accellarando/TagGang/docs/notes/links.txt

[01] S. M. Sojoudian et al., “Production and supply-chain update,” Raspberry Pi: Production and Supply Chain Update, https://www.raspberrypi.com/news/production-and-supply-chain-update/ (accessed May 10, 2023). 

[02] P. Spencer, “Achievement unlocked: 10 Years – thank you, xbox 360,” Xbox Wire, 20-Apr-2016. [Online]. Available: https://news.xbox.com/en-us/2016/04/20/xbox-360-celebrating-10-years/. [Accessed: 13-Apr-2023]. 

[03] Hickeys, “Kinect for Windows - Windows Apps,” Windows apps | Microsoft Learn. [Online]. Available: https://learn.microsoft.com/en-us/windows/apps/design/devices/kinect-for-windows. [Accessed: 14-Apr-2023]. 

[04] G. Chen, S. Baek, J.-D. Florez, W. Qian, S.-W. Leigh, S. Hutchinson, and F. Dellaert, “GTGraffiti: Spray painting graffiti art from human painting motions with a cable driven parallel robot,” in 2022 IEEE International Conference on Robotics and Automation (ICRA), 2022. [Online]. Available: https://research.gatech.edu/introducing-gtgraffiti-robot-paints-human. [Accessed: 25-Apr-2023].

[05] J. Lehni, U. Franke. "Hektor" juerglehni. [Online]. Available: https://juerglehni.com/works/hektor. [Accessed: 24-Apr-2023].

[06] Davidbliss, “Penelope: A vertical pen plotter,” davidbliss, https://davidbliss.com/2021/09/13/penelope/ (accessed May 10, 2023). 

[07] michi_teck, “MTvplot (vertical plotter),” Thingiverse, https://www.thingiverse.com/thing:2371117 (accessed May 10, 2023). 

[08] Chen, J. Microsoft Xbox 360 Kinect launches November 4. Gizmodo, 14-Jun-2010. from https://gizmodo.com/microsoft-xbox-360-kinect-launches-november-4-5563148 [Accessed: 13-Apr-2023]

[09] “Connect the sensor to the original Console - microsoft xbox 360 Kinect Manual \& Warranty [page 8],” ManualsLib, 23-Mar-2019. [Online]. Available: https://www.manualslib.com/manual/1541058/Microsoft-Xbox-360-Kinect.html?page=8\#manual. [Accessed: 13-Apr-2023]. 

[010] P. Spencer, “Achievement unlocked: 10 Years – thank you, xbox 360,” Xbox Wire, 20-Apr-2016. [Online]. Available: https://news.xbox.com/en-us/2016/04/20/xbox-360-celebrating-10-years/. [Accessed: 13-Apr-2023]. 

[011] Hickeys, “Kinect for Windows - Windows Apps,” Windows apps | Microsoft Learn. [Online]. Available: https://learn.microsoft.com/en-us/windows/apps/design/devices/kinect-for-windows. [Accessed: 14-Apr-2023]. 

[012] OpenKinect, “OpenKinect/libfreenect: Drivers and libraries for the Xbox Kinect device on windows, linux, and OS X,” GitHub. [Online]. Available: https://github.com/OpenKinect/libfreenect. [Accessed: 24-Apr-2023].

- (3992_PrototypeProposal) kinect info

- (3992_PrototypeReflection) further research -> telematic art (telegarden)

There are features in TagGang's Kinect not found in the libfreenect SDK base build that we would like to explore further through the means of other SDK integrations like finger/palm detection.

https://gmv.cast.uark.edu/scanning/hardware/microsoft-kinect-resourceshardware/

https://www.instructables.com/Polargraph-Drawing-Machine/

--- TO DO

CHANGE PEN PLOTTER TO PAINT-PEN PLOTTER

    % FIXME: The Kinect v2 face recognition, motion tracking, and resolution are much more precise than the Kinect v1
    % FIXME: No finger tracking
    % FIXME: DIFFERENT GESTURES -  Draw/move without drawing: hold out hand in front of you while drawing, pull back to stop? As a backup, if that doesn't work - hide your left hand to stop drawing Finish - button on lower right corner of screen? Punch with left hand? or a timer
    % FIXME: NOISE FROM GESTURE
    % FIXME: FAST ENOUGH MOVEMENT

- FSM DIAGRAM
- BLOCK DIAGRAM
- DEMO PIC
- PLOTTER

-----

MILESTONE 3 OCT 27

After Ella provides the blank PCB and electrical components,
Dana will solder the necessary electrical components---following the PCB schematic---that satisfy the specifications
in creating the PCB for the CNC controller. 
At the very most, this process should take 1 week: this accounts for any mistakes made while soldering as well as constant testing to avoid any electrical mishaps.

The completed custom PCB CNC controller attached to the Arduino Uno. 

Ella will create custom 3D-printed parts given by Dana's plotter design specifications which will take 1 week.
 
The design includes the frame's bar and attachments for the stepper motor and toothed cable housing, paint-pen holder, and counterweights.
Then Dana will assemble the plotter's hardware setup and connect it to the rest of the TagGang system in a temporary
environment within 1 week.

Modifications to GRBL for polar plotting should be ready in 1 week within the given time frame and before testing 
of the assembled plotter. 

The temporary environment will allow basic testing of the plotter which is conducted by both members and
subsequently documented, taking 1 week.
