accellarando/TagGang/docs/hardware/plotter.html

# Vertial Paint Pen-Plotter

The plotter for TagGang was comprised of custom-fitted 3D prints, a vertically-elongated rolling whiteboard, 2-phase 1.8 degree/step stepper motors, timing belt and pulley, ball bearings, alongside the various wires and power adapters.
This cable-driven plotter mounts stepper motors to the top corners of the whiteboard. The timing belt is threaded through the mounts, interlocking with the timing pulleys on each stepper motor, and ending with a counterweight that holds pennies. The other end of the belt is attached to an arm of the gondola. The gondola holds the paint pen and servo motor that lifts the gondola off the paper. Long wires connect the motors to the custom Pi Hat hardware to drive them.

## Demo Day Plotter

TagGang's final version of the plotter utilized the CADE lab's vertically-elongated plotter, wrapped with 6' of white butcher paper.
Connecting wires and power adapters not shown in the picture below, but were laid out on the table.

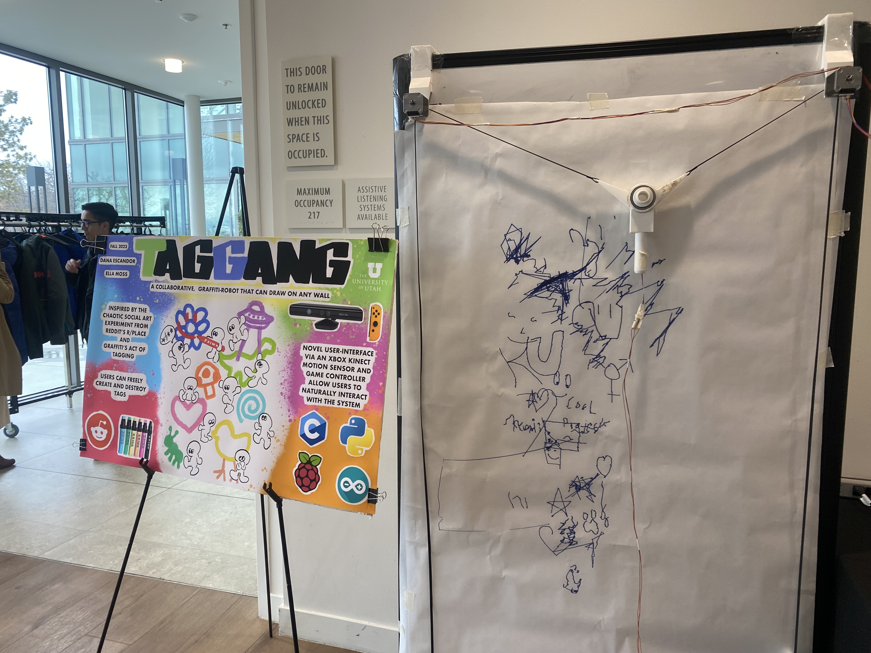
[picture p1: docs/images/taggang-plotter.jpg]
Final Plotter


TagGang's Plotter on Demo Day

Links to plotter items purchased from Amazon, Mouser, and STMicroelectronics:
2x 1 inch ID x 2 inch bearings (https://www.amazon.com/gp/product/B086PVD4XH)
1x 5 meter timing belt and 2x pulleys (https://www.amazon.com/gp/product/B07Y33MF7R?th=1)
1x 9g servo motor (https://www.amazon.com/gp/product/B07Q6JGWNV?th=1)
2x SF2424-10B11 stepper motors (https://www.mouser.com/ProductDetail/SANMOTION/SF2424-10B11?qs=l4Gc20tDgJJPaqhJYMlonw%3D%3D)
2x x-nucleo-ihm05a1 stepper motor driver (https://www.st.com/en/ecosystems/x-nucleo-ihm05a1.html)
1x power adapter (https://www.amazon.com/gp/product/B08C594VNP?th=1)
1x raspberry pi 4 (https://www.raspberrypi.com/products/raspberry-pi-4-model-b/)
Other components bought the from the stockroom or the campus bookstore included: wires, butcher paper, paint pens.

## Plotter Versions

The plotter build went through various iterations and the original build was ultimately scrapped. The original design was geared toward a width-elongated rolling frame as seen in the design:

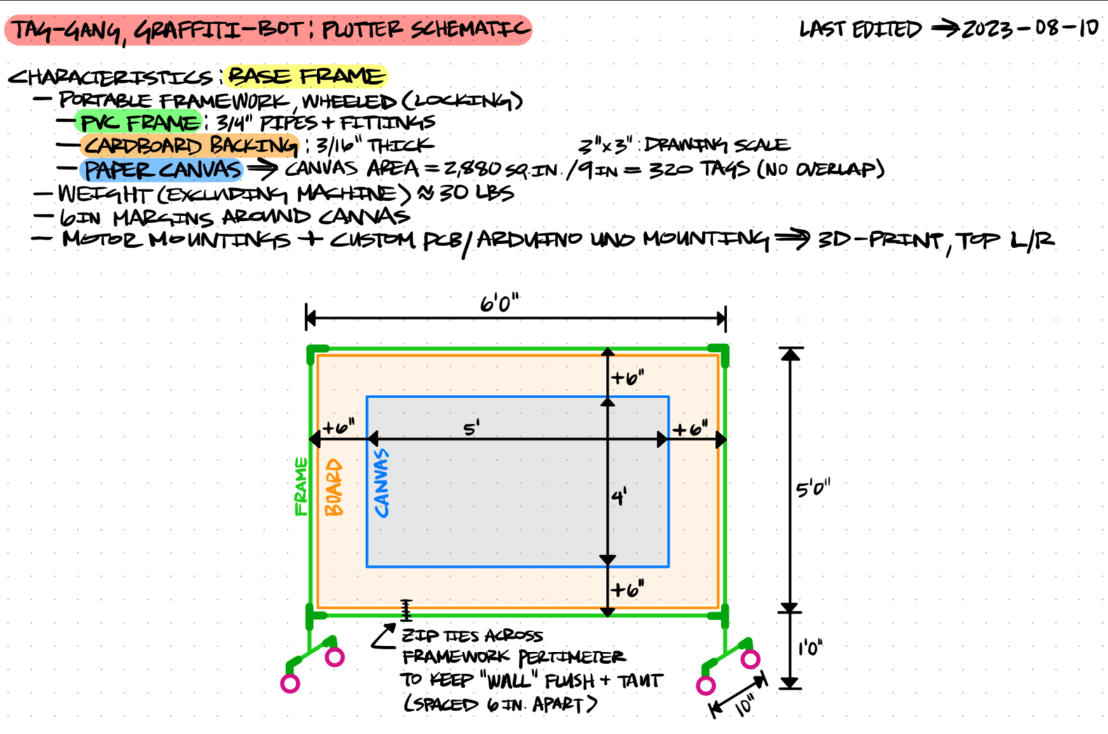
[picture p2: docs/images/PlotterFrame.png]
Final Plotter


V1 plotter schematic

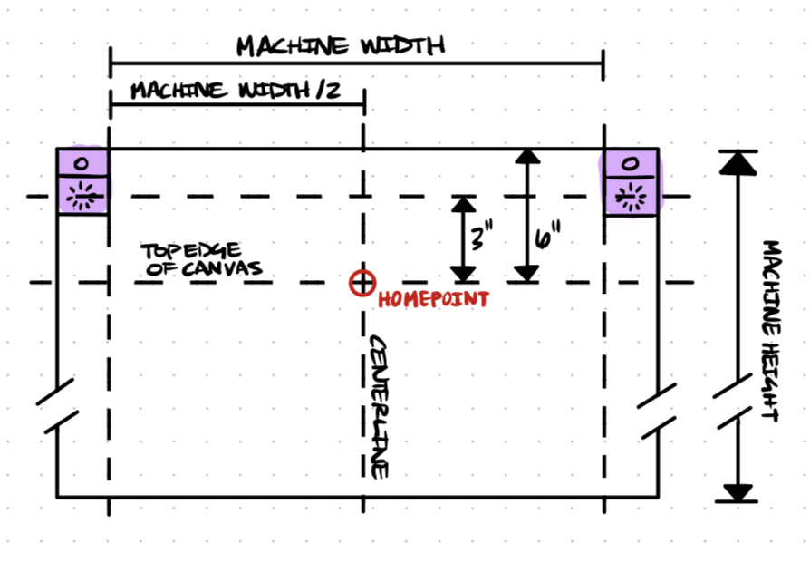
[picture p3: docs/images/PlotterPlacement.png]
Final Plotter


Margins and boundaries for V1 plotter

This first verion was constructed out of PVC pipes and the backing was either cardboard or poster foam board.
The PVC frame was constructed but finding the backing proved to be expensive. Custom sized boards would be an additional cost we didn't want to splurge on. Trying to use recycled cardboard and poster foam boards made an uneven surface:

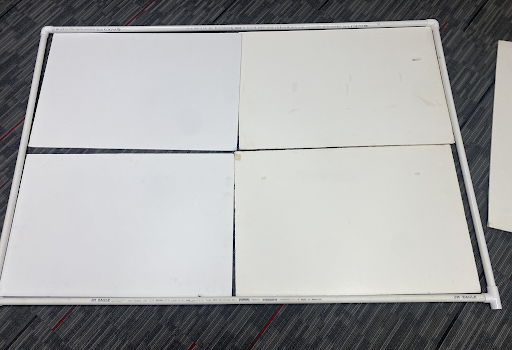
[picture p4: docs/images/plotterv1.png]
Final Plotter


V1 plotter laid out

We then received a thin whiteboard from our professor but was too flimsy and could not hold the weight of the stepper motors:

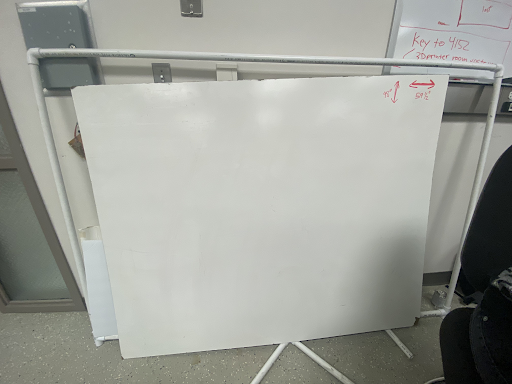
[picture p5: docs/images/whiteboard.png]


Given whiteboard for V2

## 3D-Prints

There were multiple versions of the 3D-prints due to the verious versions of the plotter. The working and final 3D prints can be found in our repo within selector-commands branch in plotter-frame (https://github.com/accellarando/TagGang/tree/selector-commands/plotter-frame).
Here's a preview of one print, the gondola:

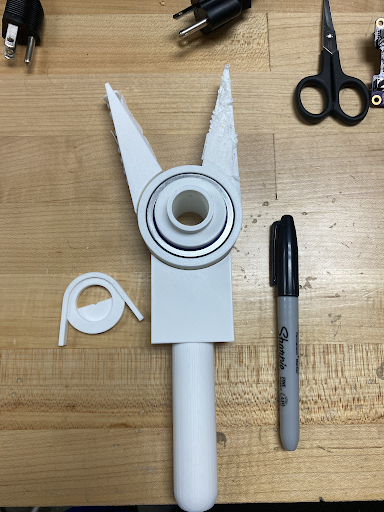
[picture p6: docs/images/gondola-front.png]


gondola front

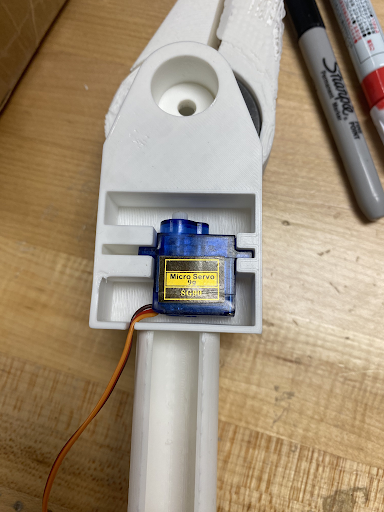
[picture p7: docs/images/gondola-back.png]


gondola back
