accellarando/TagGang/docs/hardware/hat.html

# CNC Pi HAT

As part of our project, we have designed a custom PCB to interface with the Raspberry Pi. Raspberry Pi has published a specification (https://github.com/raspberrypi/hats/) for breakout boards, called the Pi HAT (Hardware Attached on Top). These boards communicate with the Pi over GPIO pins, which can also be programmed to perform functions such as serial output.
The TagGang project requires fine stepper motor and servo control. The Raspberry Pi, which runs a desktop operating system, is not equipped for this timing-sensitive application. To meet this need, the team has decided to design a Pi HAT with a microcontroller to extend the capabilities of the Raspberry Pi. This PCB contains a microcontroller, stepper motor drivers, and an Arduino.
The team decided on an Arduino due to existing support for CNC applications, with libraries such as GRBL (https://github.com/gnea/grbl).

## Schematic

Ella designed the schematic for the Pi HAT, which contains a microcontroller, two DRV8825 stepper motor drivers, and other hardware to link everything together (such as level shifters - the Pi runs at 3.3V, while the Arduino runs at 5V).

## PCB

After the schematic was finished, the PCB was designed to the Pi HAT specification, linked above.

## Files

Browse the GitHub (https://github.com/accellarando/TagGang/tree/main/hardware) for the schematic, board layout, and bill of materials.
