accellarando/TagGang/hardware/CAMOutputs/ImageFiles/ v27.pdf

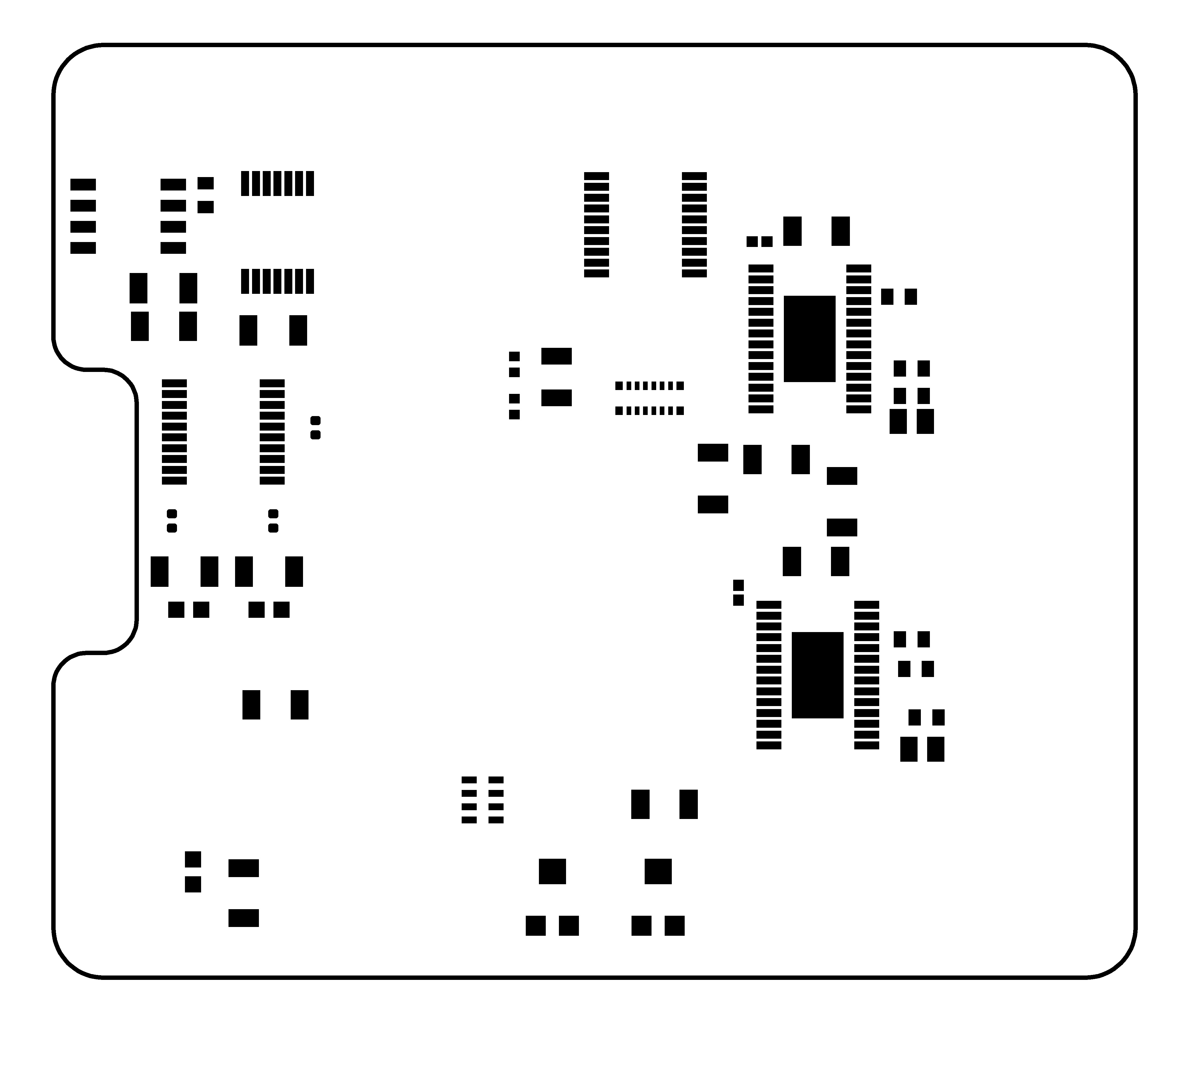
[picture p8: figure]

Image 1
