accellarando/TagGang/hardware/CAMOutputs/ImageFiles/5780/TagGang/CAMOutputs/ImageFiles/Image 1.pdf

Image 1
