accellarando/TagGang/docs/images/3DprintStepperMount.png

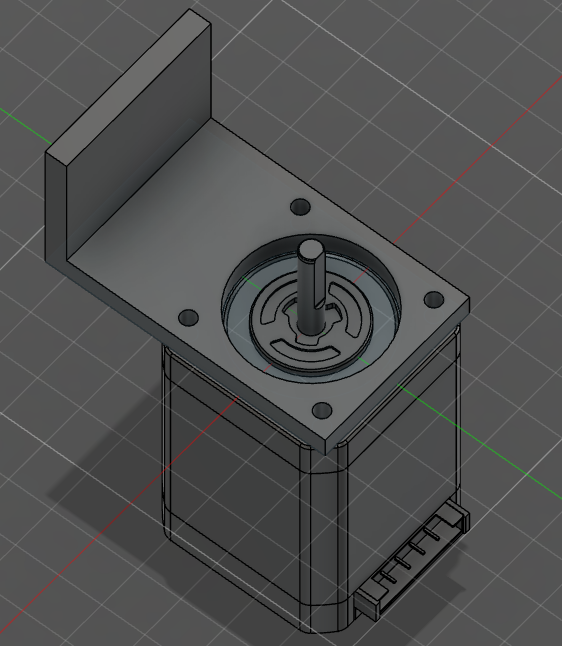
docs/images/3DprintStepperMount.png
