accellarando/TagGang/docs/images/dana.jpg

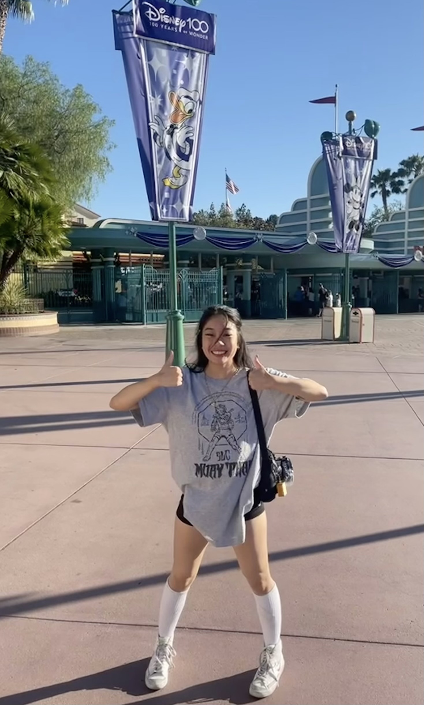
docs/images/dana.jpg
