accellarando/TagGang/docs/images/ella.jpg

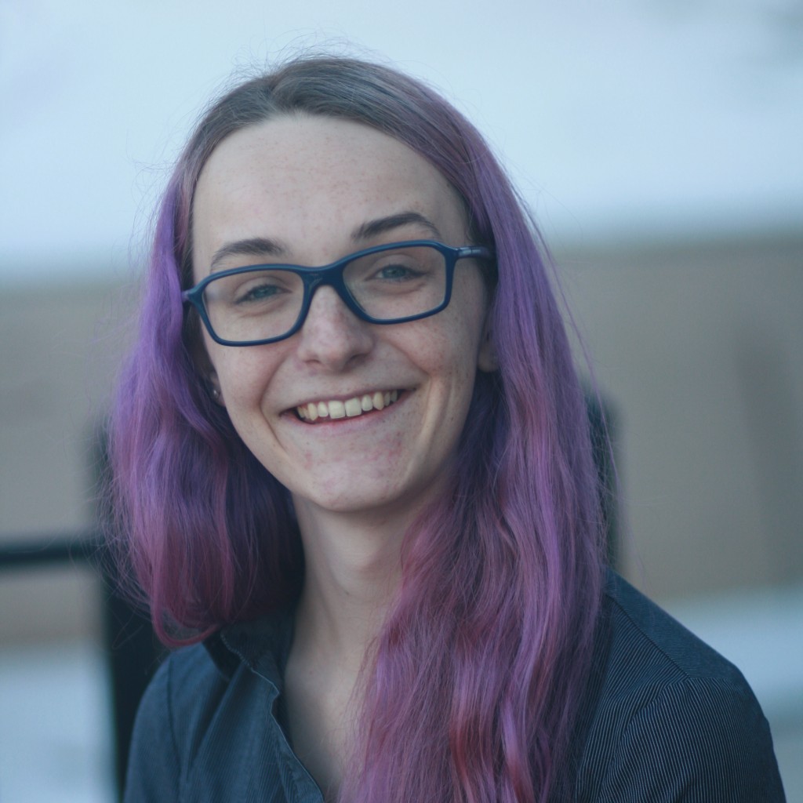
docs/images/ella.jpg
