accellarando/TagGang/docs/images/GTGraffiti.PNG

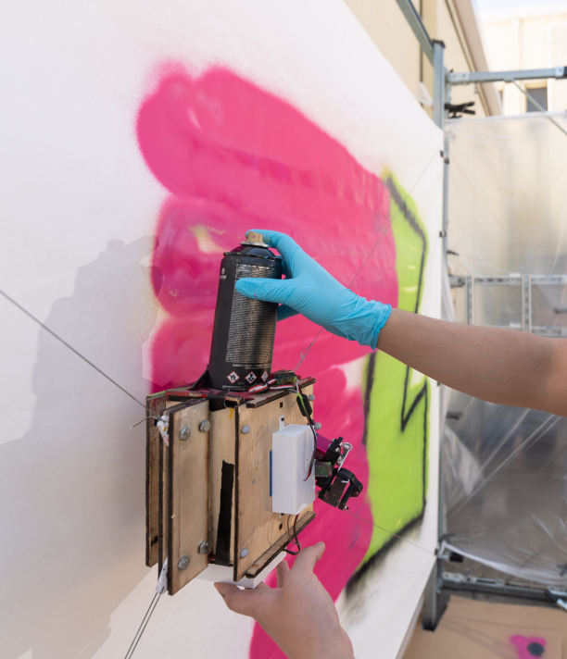
docs/images/GTGraffiti.PNG
