accellarando/TagGang/docs/images/HektorTitlesAShow.PNG

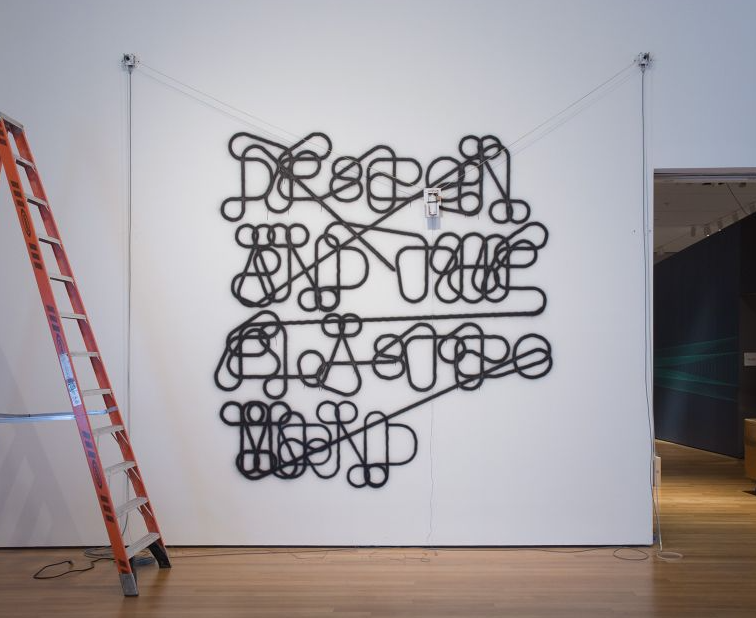
docs/images/HektorTitlesAShow.PNG
