accellarando/TagGang/docs/images/pcb.png

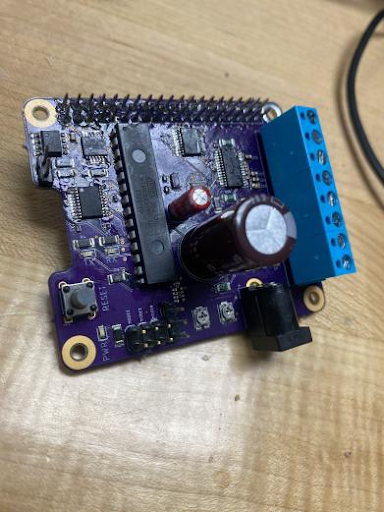
docs/images/pcb.png
