accellarando/TagGang/docs/images/Penelope.PNG

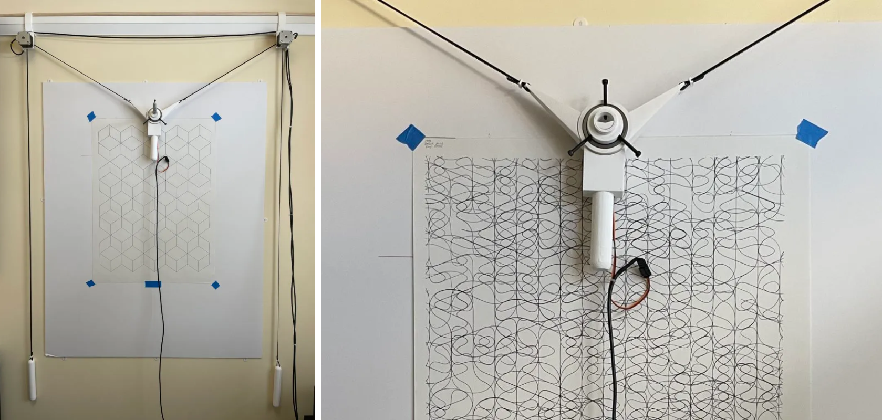
docs/images/Penelope.PNG
