accellarando/TagGang/docs/images/PiHat.jpg

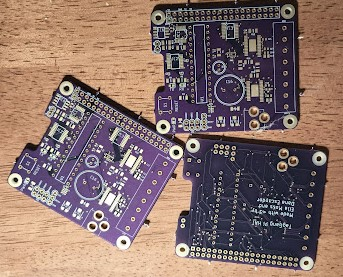
docs/images/PiHat.jpg
