accellarando/TagGang/docs/images/PlotterUnfin.jpg

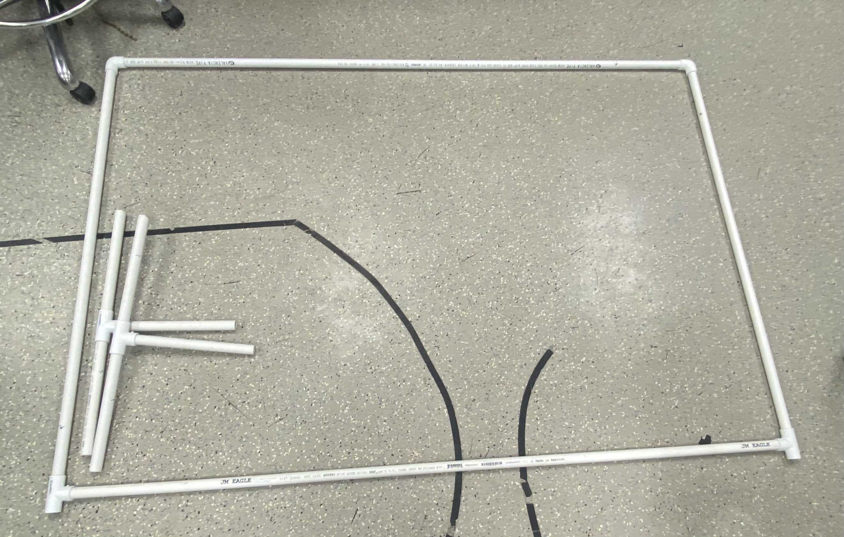
docs/images/PlotterUnfin.jpg
