accellarando/TagGang/docs/images/PrototypeBlockDiagram.png

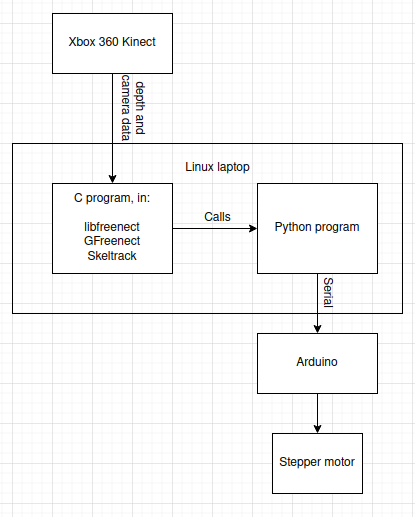
docs/images/PrototypeBlockDiagram.png
