accellarando/TagGang/docs/images/TagGangBlockDiagram.png

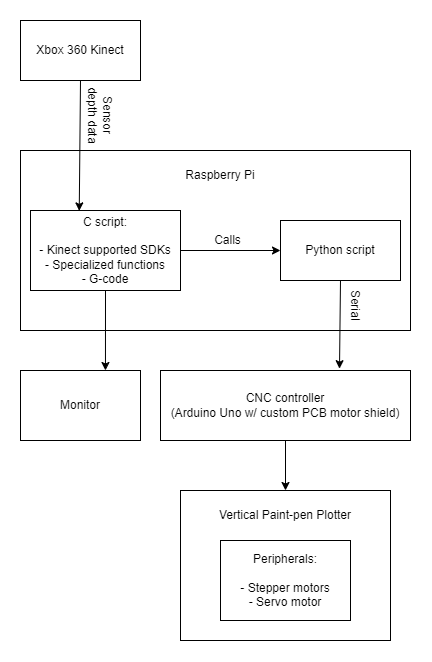
docs/images/TagGangBlockDiagram.png
