accellarando/TagGang/docs/images/TagGangDemo.png

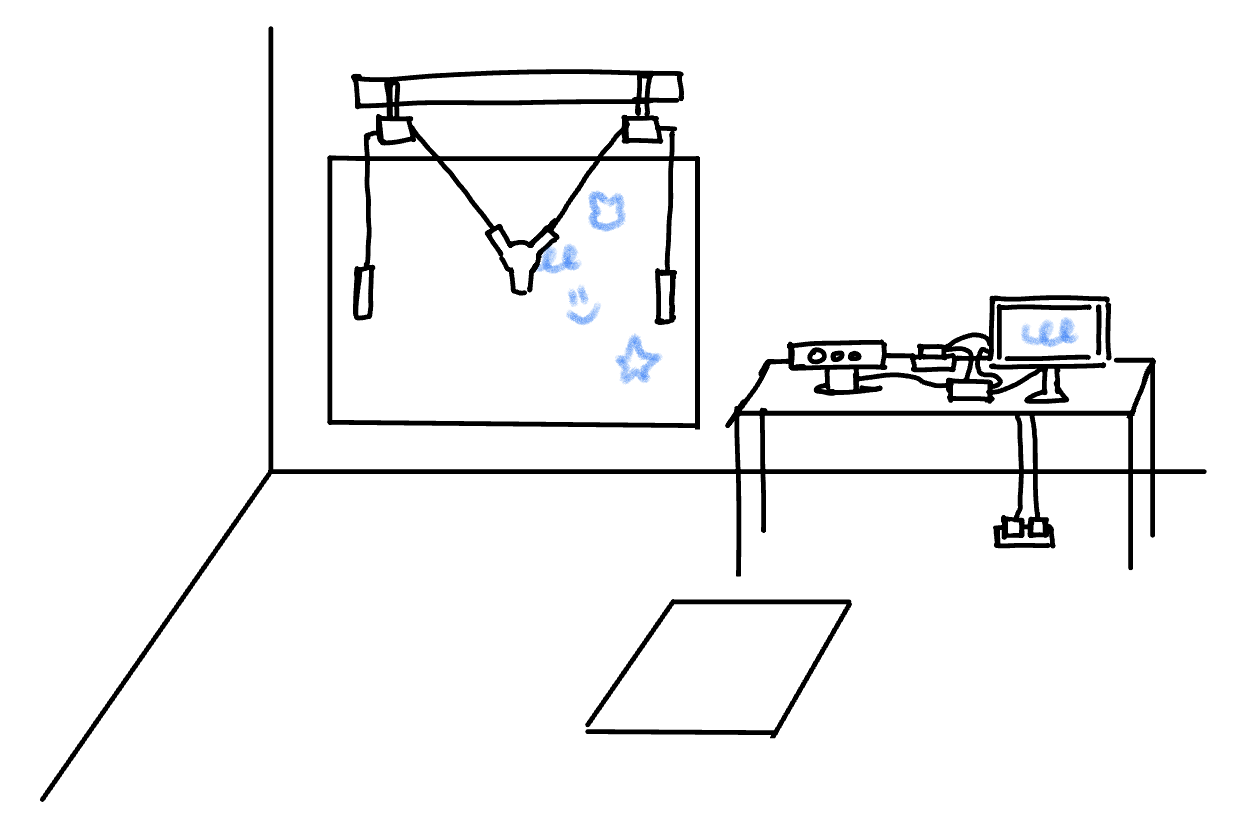
docs/images/TagGangDemo.png
