accellarando/TagGang/hardware/blockDiagram.png

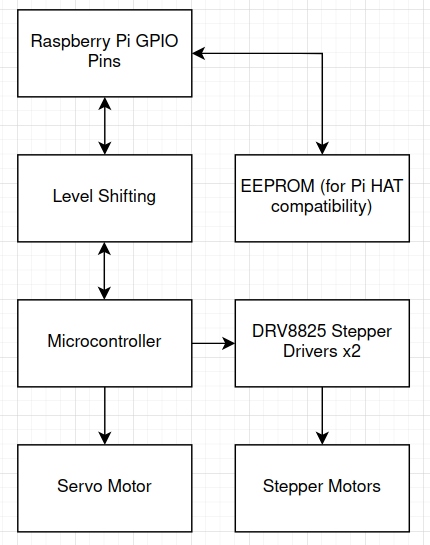
hardware/blockDiagram.png
