accellarando/TagGang/hardware/Schematic-v1.3.png

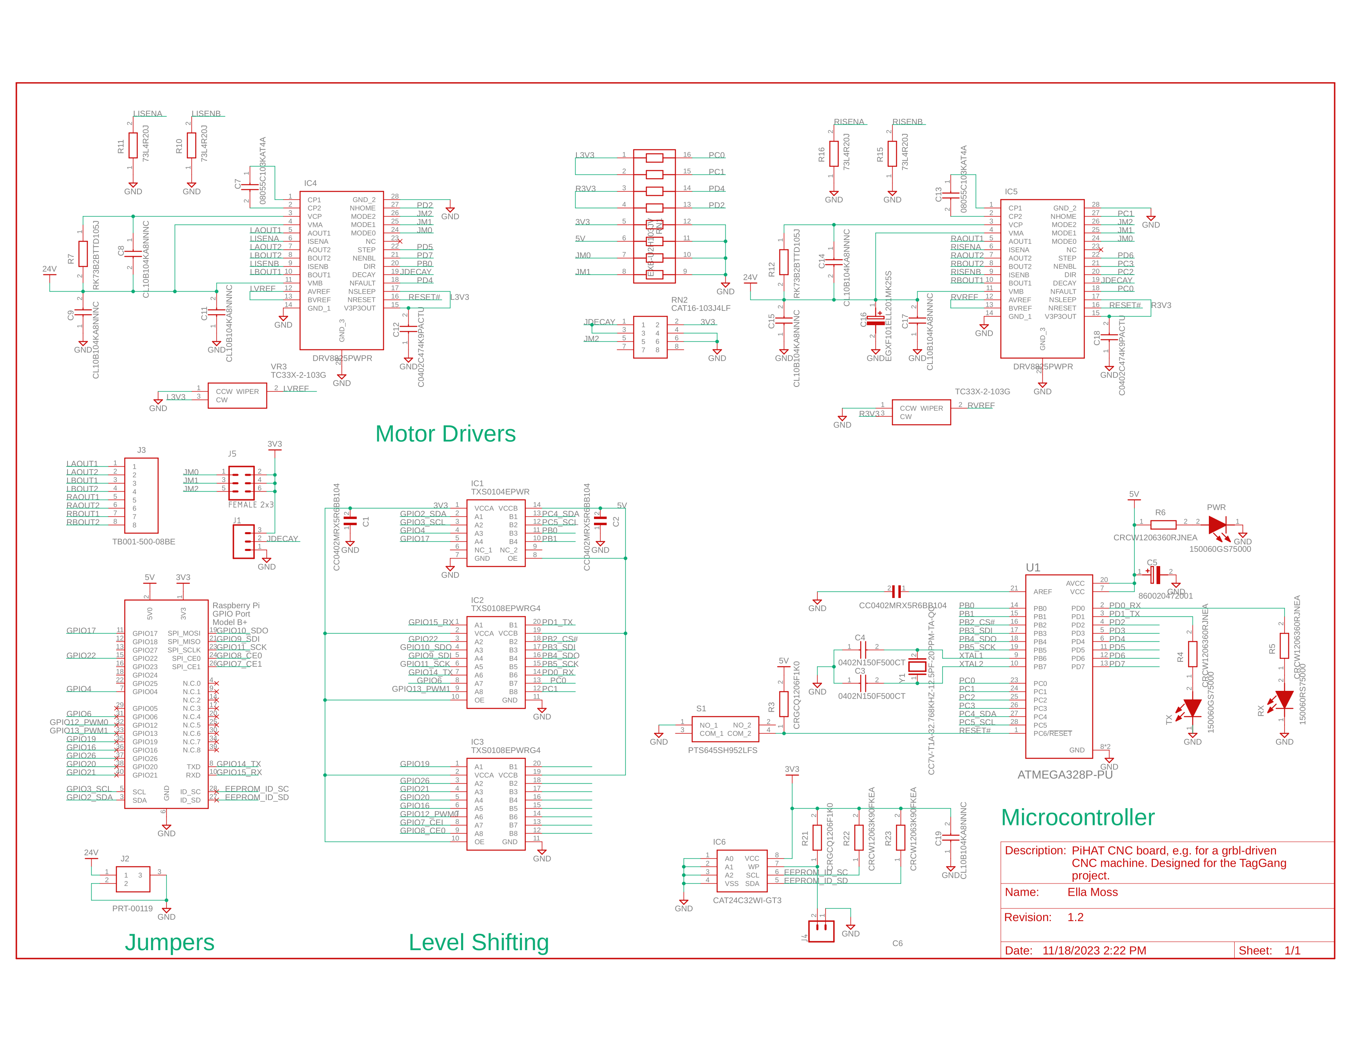
hardware/Schematic-v1.3.png
