accellarando/TagGang/software/images/flower.png

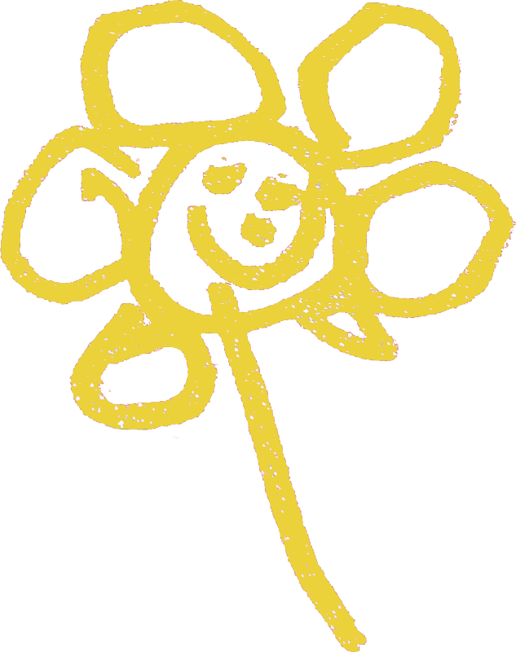
software/images/flower.png
