accellarando/TagGang/software/images/stick-figure.png

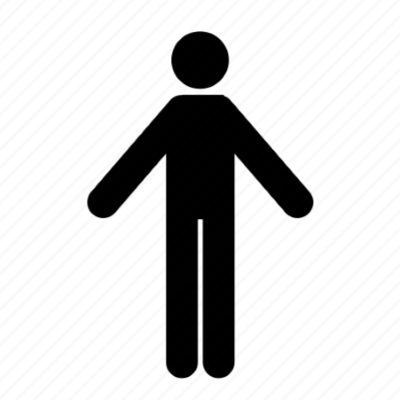
software/images/stick-figure.png
