accellarando/TagGang/hardware/BOM-v1.2.ods

Qty | Value | Parts | Device | DESCRIPTION | Price | Total Cost | MOUSER LINK
1 | CONN_02 | J4 | CONN_02 |  |  | 0
1 | CONN_03 | J1 | CONN_03 |  |  | 0
2 | 0402N150F500CT | C3, C4 | 0402N150F500CT | Multilayer Ceramic Capacitors MLCC - SMD/SMT 0402 MLCC NPO 15 pF +/- 1% 50 V T&R GP | $0.10 | $0.20 | https://www.mouser.com/ProductDetail/Walsin/0402N150F500CT?qs=ZrPdAQfJ6DMIGRPPEte55Q%3D%3D
2 | 08055C103KAT4A | C7, C13 | 08055C103KAT4A | Multilayer Ceramic Capacitors MLCC - SMD/SMT 50V .01uF X7R 0805 10%TOL | $0.10 | $0.20 | https://www.mouser.com/ProductDetail/KYOCERA-AVX/08055C103KAT4A?qs=rjW0lv%2FNY4MU4YjuQDXlLw%3D%3D
2 | 150060GS75000 | PWR, TX | 150060GS75000 | Wurth Elektronik WL-SMCW 520 nm Green LED, 1608 (0603) Clear SMD package | 0.15 | 0.3 | https://www.mouser.com/ProductDetail/Wurth-Elektronik/150060GS75000?qs=LlUlMxKIyB0UYkq5lDO8nA%3D%3D
1 | 150060RS75000 | RX | 150060RS75000 | WURTH ELEKTRONIK - 150060RS75000 - LED, 0603, RED, 250MCD, 625NM | $0.15 | $0.15 | https://www.mouser.com/ProductDetail/Wurth-Elektronik/150060RS75000?qs=LlUlMxKIyB3QnmZ3fw%2FVCA%3D%3D
4 | 73L4R20J | R10, R11, R15, R16 | 73L4R20J | Current Sense Resistors - SMD 0.2ohms 5% | $0.21 | $0.84 | https://www.mouser.com/ProductDetail/CTS-Electronic-Components/73L4R20J?qs=hbgUSdfWRJU6l%2FyD8DKbaA%3D%3D
1 | 860020472001 | C5 | 860020472001 | Wurth Elektronik 4.7uF 25 V dc Aluminium Electrolytic Capacitor, WCAP-ATG5 Series 2000h 5 (Dia.) x 11mm | $0.10 | $0.10 | https://www.mouser.com/ProductDetail/Wurth-Elektronik/860020472001?qs=0KOYDY2FL2%2F%252BlYkeK95R6A%3D%3D
1 | ATMEGA328P-PU | U1 | ATMEGA328P-PU | microcontroller | $2.97 | $2.97 | https://www.mouser.com/ProductDetail/Microchip-Technology/ATMEGA328P-PU?qs=K8BHR703ZXguOQv3sKbWcg%3D%3D
2 | C0402C474K9PACTU | C12, C18 | C0402C474K9PACTU | SMD Comm X5R, Ceramic, 0.47 uF, 10%, 6.3 VDC, 15.75 VDC, 85C, -55C, X5R, SMD, MLCC, Temperature Stable, Class II, 10 % , 1.0638 GOhms, 1.21 mg, 0402, 1mm, 0.5mm, 0.5mm, 0.3mm, 0.3mm, 10000, 78 Weeks, 70 | $0.10 | $0.20 | https://www.mouser.com/ProductDetail/KEMET/C0402C474K9PACTU?qs=KHg1sw%2FVM5RivoKJ3oVJkQ%3D%3D
1 | CAT24C32WI-GT3 | IC6 | CAT24C32WI-GT3 | EEPROM Serial-I2C 32K 4Kx8 1.8V/5V SOIC8 CAT24C32WI-GT3, EEPROM Memory 32kbit,, 4096 x, 8bit, Serial-I2C 1.7 5.5 V, 8-Pin SOIC | $0.37 | $0.37 | https://www.mouser.com/ProductDetail/onsemi/CAT24C32WI-GT3?qs=rZgeL6XvLwaTa79VuYkKQA%3D%3D
3 | CC0402MRX5R6BB104 | C1, C2, C6 | CC0402MRX5R6BB104 | 0.1 µF ±20% 10V Ceramic Capacitor X5R 0402 (1005 Metric) | 0.12 for 10 | $0.12 | https://www.mouser.com/ProductDetail/YAGEO/CC0402MRX5R6BB104?qs=57cj7OiSijkr3nExJ5eVHg%3D%3D
1 | CC7V-T1A-32.768KHZ-12.5PF-20PPM-TA-QC | Y1 | CC7V-T1A-32.768KHZ-12.5PF-20PPM-TA-QC | LOW FREQUENCY CRYSTAL | $0.71 | $0.71 | https://www.mouser.com/ProductDetail/Micro-Crystal/CC7V-T1A-32.768kHz-12.5pF-20PPM-TA-QC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
7 | CL10B104KA8NNNC | C8, C9, C11, C14, C15, C17, C19 | CL10B104KA8NNNC | Ceramic cap 0603 X7R 25V 100nF (Reel) Samsung Electro-Mechanics 100nF Multilayer Ceramic Capacitor (MLCC) 25 V +/-10% X7R dielectric CL max op. temp. +125C | $0.14 for 10 | $0.14 | https://www.mouser.com/ProductDetail/Samsung-Electro-Mechanics/CL10B104KA8NNNC?qs=349EhDEZ59rmu3pGeZXx0A%3D%3D
3 | CRCW1206360RJNEA | R4, R5, R6 | CRCW1206360RJNEA | Thick Film Resistors - SMD 1/4watt 360ohms 5% | 0.1 | 0.3 | https://www.mouser.com/ProductDetail/Vishay-Dale/CRCW1206360RJNEA?qs=f6iYHOF0qgQa5fU%252BdQhP8Q%3D%3D
2 | CRCW12063K90FKEA | R22, R23 | CRCW12063K90FKEA | CRCW1206 Resistor T/R 0.25W,1%,3K9 Vishay CRCW Series Thick Film Surface Mount Resistor 1206 Case 3.9k +/-1% 0.25W +/-100ppm/C | 0.1 | 0.2 | https://www.mouser.com/ProductDetail/Vishay-Dale/CRCW12063K90FKEA?qs=cIcnZvs8mCNkQ0vWXL23Cw%3D%3D
2 | CRGCQ1206F1K0 | R3, R21 | CRGCQ1206F1K0 | SMD AEC-Q200 Compliant Thick Film Chip Resistor, | 0.1 | 0.2 | https://www.mouser.com/ProductDetail/TE-Connectivity-Holsworthy/CRGCQ1206F1K0?qs=wUXugUrL1qxm2LgdVtGvlQ%3D%3D
2 | DRV8825PWPR | IC4, IC5 | DRV8825PWPR | 2.5A Bipolar Stepper Motor Driver with On-Chip 1/32 Microstepping Indexer (Step/Dir Ctrl) | 5.57 | 11.14 | https://www.mouser.com/ProductDetail/Texas-Instruments/DRV8825PWPR?qs=L4ss%2FyqpMWRQV%252B0JWK8r%2FQ%3D%3D
1 | EGXF101ELL201MK25S | C16 | EGXF101ELL201MK25S | Aluminum Electrolytic Capacitors - Radial Leaded 200uF 100 Volts 20% | 2.41 | 2.41 | https://www.mouser.com/ProductDetail/Chemi-Con/EGXF101ELL201MK25S?qs=8BXZADTIn4FXlUL9JzZ4Ow%3D%3D
1 | EXB-U2H103JV | RN1 | EXB-U2H103JV | Series/Type: Anti-Sulfurated Chip Resistor Array, Power Rating (W): 0.063, Chip Size (LxW) (mm): 3.8 X 1.6, Resistance Values (): 10000, Resistance Tolerance (%): 5, Terminal Pitch (mm): 0.5, Type of Circuit: Isolated Circuit, Number of Elements (piece): 8, T.C.R (10/K): +/-200, Number of Terminals (piece): 16 | 0.41 | 0.41 | https://www.mouser.com/ProductDetail/Panasonic/EXB-U2H103JV?qs=Z3CaLxJiOJJ7jC1v10U%2Fjw%3D%3D
1 | CAT16-103J4LF | RN2 | CAT16-103J4LF | 4x 10k Resistor Network | 0.1 | 0.1 | https://www.mouser.com/ProductDetail/Bourns/CAT16-103J4LF?qs=yksRZAkH7gsi20GVw368rQ%3D%3D
1 | FEMALE 2x3 | J5 | CONN_03X2FEMALE |  |  | 0
1 | PRT-00119 | J2 | PRT-00119 | SparkFun Accessories DC Barrel Power Jack/Connector | 1.25 | 1.25 | https://www.mouser.com/ProductDetail/SparkFun/PRT-00119?qs=WyAARYrbSnbnQpS9xf%252Bx5A%3D%3D
1 | PTS645SH952LFS | S1 | PTS645SH952LFS | SWITCH TACTILE SPST-NO 0.05A 12V | 0.23 | 0.23 | https://www.mouser.com/ProductDetail/CK/PTS645SH952LFS?qs=FQH5YrIbzh%252B2bZJSGdqIFg%3D%3D
1 | RASPI_BOARD_B+_HD | X1 | RASPI_BOARD_B+_HD |  | 1.94 | 1.94 | https://www.mouser.com/ProductDetail/SparkFun/PRT-16763?qs=W%2FMpXkg%252BdQ5xeCq%2FGKjnlQ%3D%3D
2 | RK73B2BTTD105J | R7, R12 | RK73B2BTTD105J | Thick Film Resistors - SMD 1/4watts 1Mohms 5% | 0.1 | 0.2 | https://www.mouser.com/ProductDetail/KOA-Speer/RK73B2BTTD105J?qs=R%2FhS%252B3qKYyBMnZWhPzrWSA%3D%3D
1 | TB001-500-08BE | J3 | TB001-500-08BE | Fixed Terminal Blocks Terminal block, screw type, 5.00 , horizontal, 8 poles, CUI Blue, slotted screw, PCB mount | 1.29 | 1.29 | https://www.mouser.com/ProductDetail/CUI-Devices/TB001-500-04BE
2 | TC33X-2-103G | VR3, VR4 | TC33X-2-103G | Trimmer Resistors - SMD 3MM 10KOHMS 25% 0.1WATT OPEN FRM | 0.28 | 0.56 | https://www.mouser.com/ProductDetail/Bourns/TC33X-2-103G
1 | TXS0104EPWR | IC1 | TXS0104EPWR | TXS0104EPWR, Voltage Level Translator, Open Drain 1.65 3.6 V, 2.3 5.5 V 14-Pin TSSOP | 1.15 | 1.15 | https://www.mouser.com/ProductDetail/Texas-Instruments/TXS0104EPWR?qs=7kv20MEVUlglsv2MH6ZndA%3D%3D
2 | TXS0108EPWRG4 | IC2, IC3 | TXS0108EPWRG4 | Translation - Voltage Levels 8B Bidir Vltg-Level Translator | 1.53 | 3.06 | https://www.mouser.com/ProductDetail/595-TXS0108EPWRG4
 |  |  |  |  | SUM: | 30.74
