accellarando/TagGang/hardware/5780/TagGang/CAMOutputs/DrawingFiles/ v27.dxf

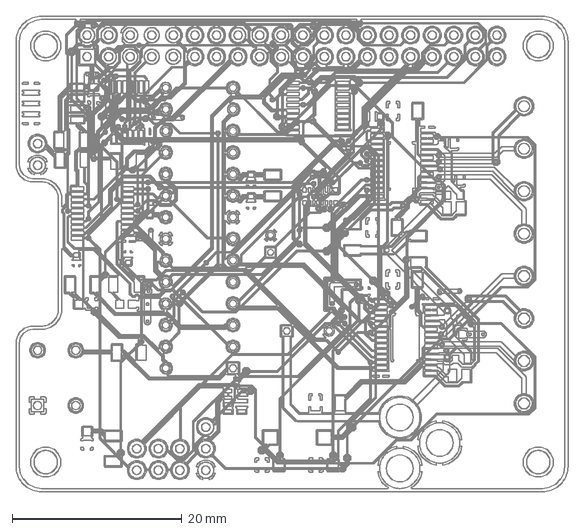
[picture p25: CAD file, 2023-11-14]
hardware/5780/TagGang/CAMOutputs/DrawingFiles/ v27.dxf
65.0 x 56.0 mm
