accellarando/TagGang/hardware/CAMOutputs/DrawingFiles/PiHatOshpark.dxf

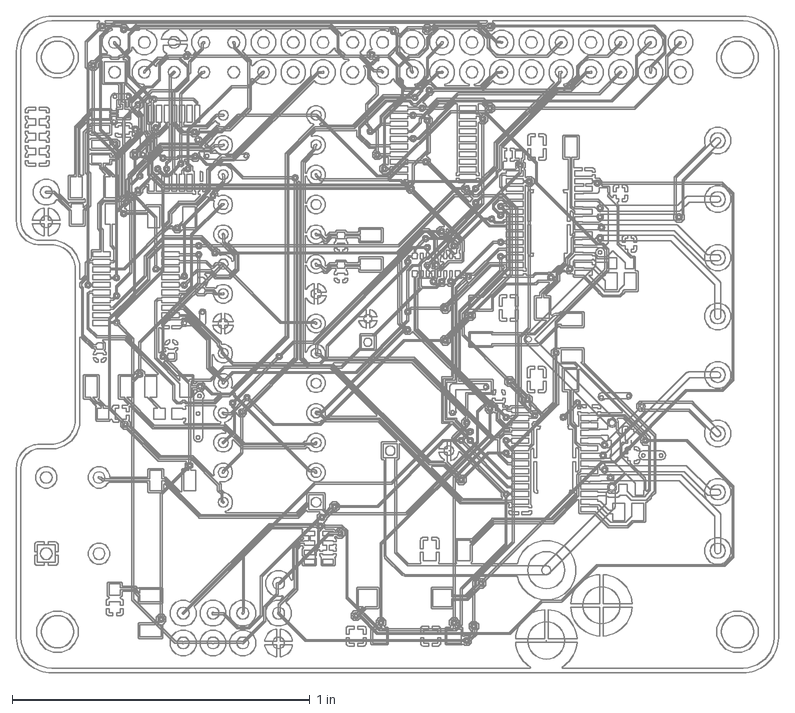
[picture p26: CAD file, 2023-11-14]
hardware/CAMOutputs/DrawingFiles/PiHatOshpark.dxf
2.56 x 2.20 in
