accellarando/TagGang/plotter-frame/gondola-2.stl

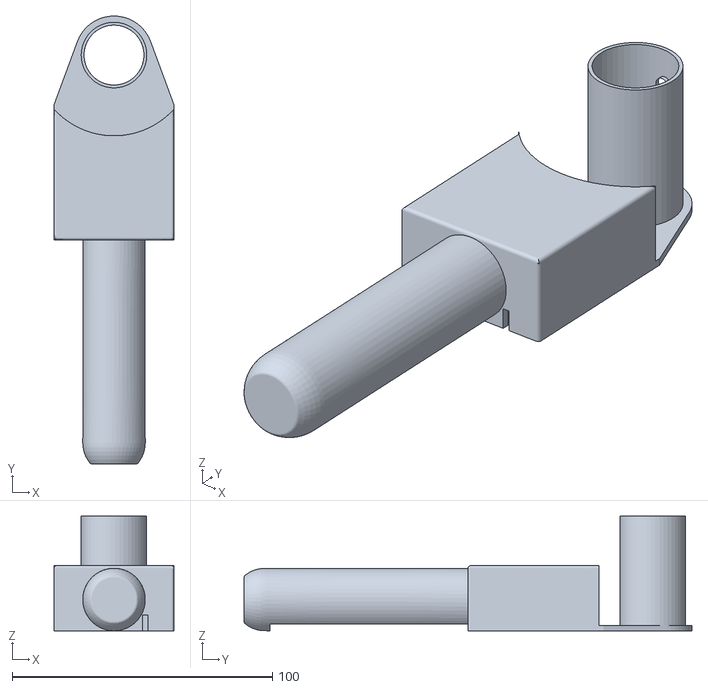
[picture p27: CAD file, 2023-12-21]
plotter-frame/gondola-2.stl
46.0 x 172.0 x 44.0
