accellarando/TagGang/plotter-frame/stl/servo-extender.stl

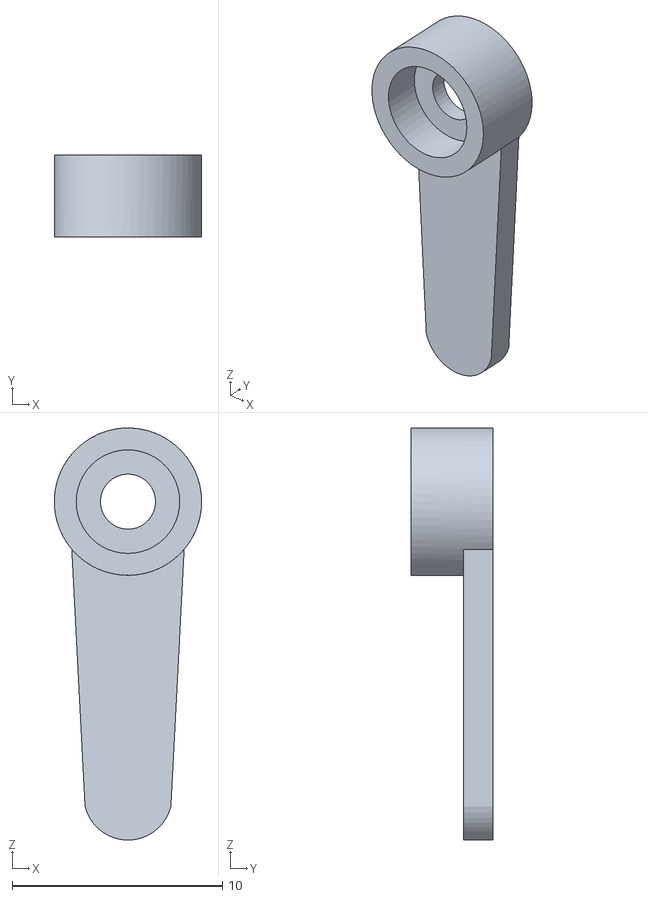
[picture p28: CAD file, 2023-11-25]
plotter-frame/stl/servo-extender.stl
7.00 x 3.91 x 19.6
