accellarando/TagGang/plotter-frame/stl/pulley-holder.stl

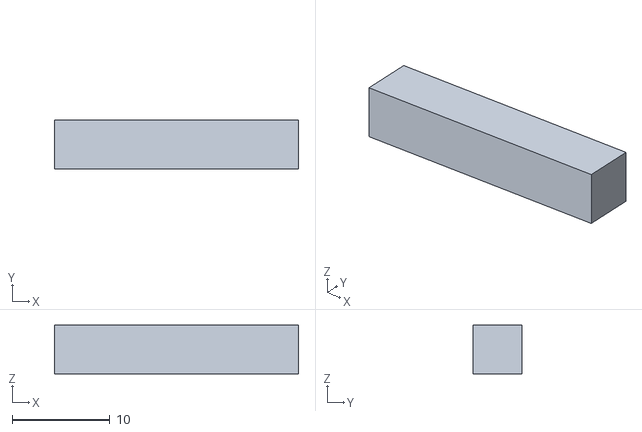
[picture p29: CAD file, 2023-11-25]
plotter-frame/stl/pulley-holder.stl
25.0 x 5.00 x 5.00
