accellarando/TagGang/plotter-frame/stepper-motor-mount-fin-1.stl

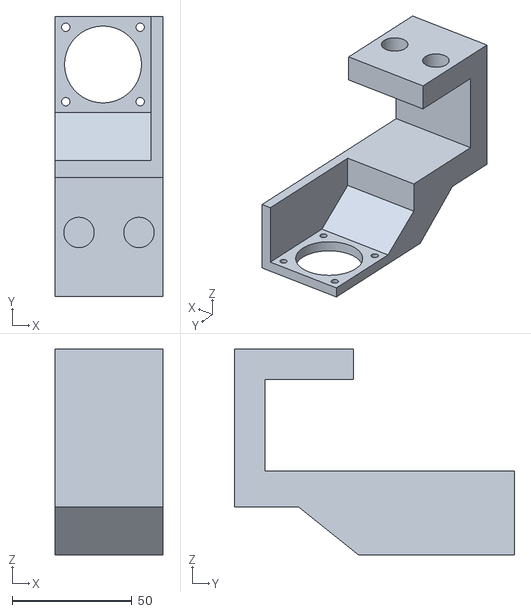
[picture p30: CAD file, 2023-12-21]
plotter-frame/stepper-motor-mount-fin-1.stl
45.0 x 116.7 x 85.8
