accellarando/TagGang/plotter-frame/stl/StepperMotorMount_2_v2.stl

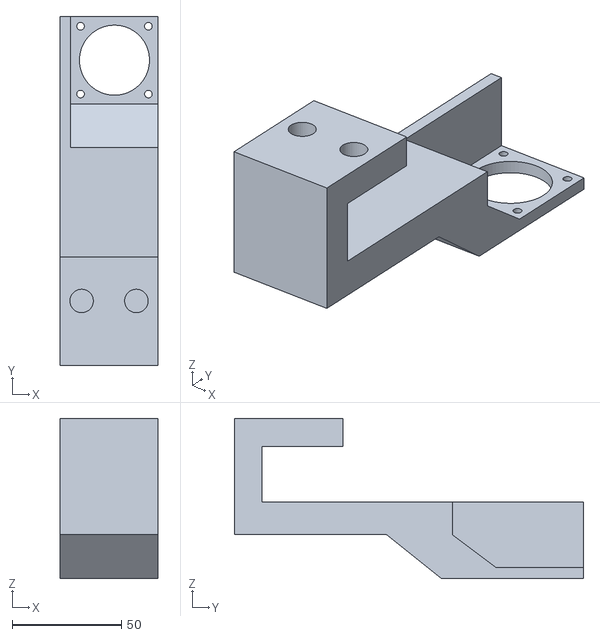
[picture p31: CAD file, 2023-11-20]
plotter-frame/stl/StepperMotorMount_2_v2.stl
45.0 x 159.5 x 73.1
