accellarando/TagGang/plotter-frame/Stepper+Motor+Mount+2.stl

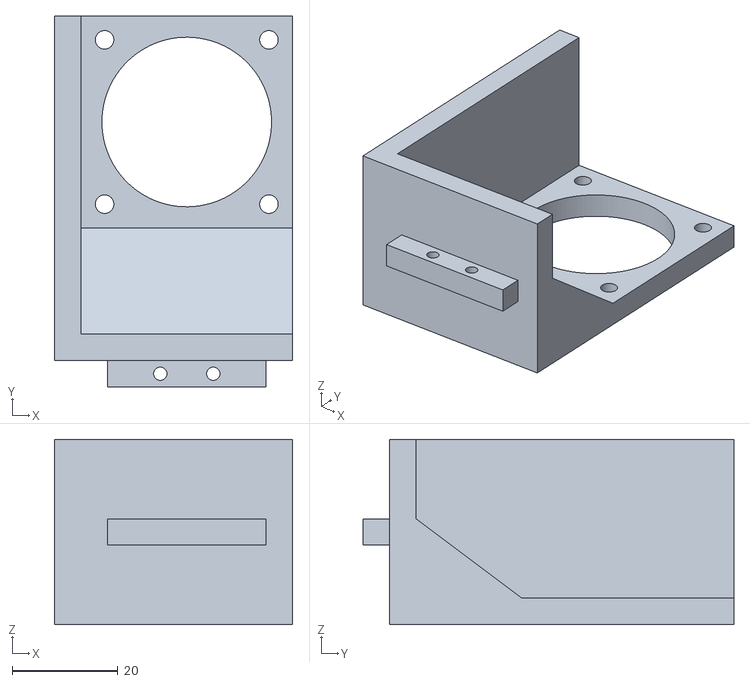
[picture p32: CAD file, 2023-10-31]
plotter-frame/Stepper+Motor+Mount+2.stl
45.0 x 70.0 x 35.0
