accellarando/TagGang/plotter-frame/SANMOTION-F2-SF2424-10B11.STEP

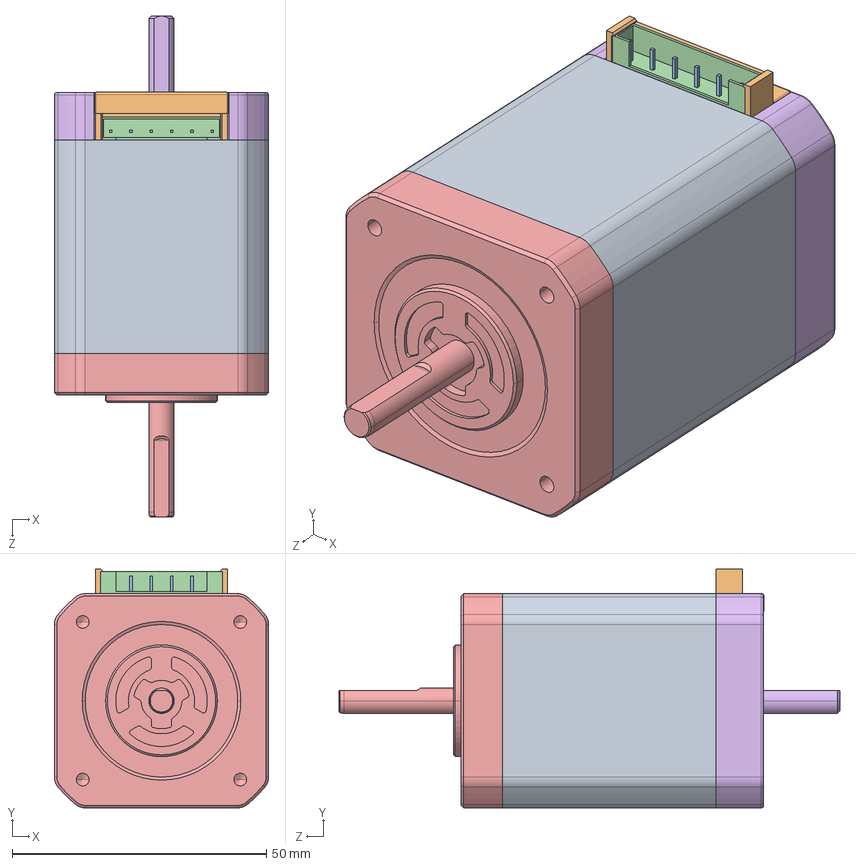
[picture p33: CAD file, 2023-09-04]
plotter-frame/SANMOTION-F2-SF2424-10B11.STEP
42.2 x 47.0 x 98.6 mm
