accellarando/TagGang/plotter-frame/Stepper Motor Mount v1.stl

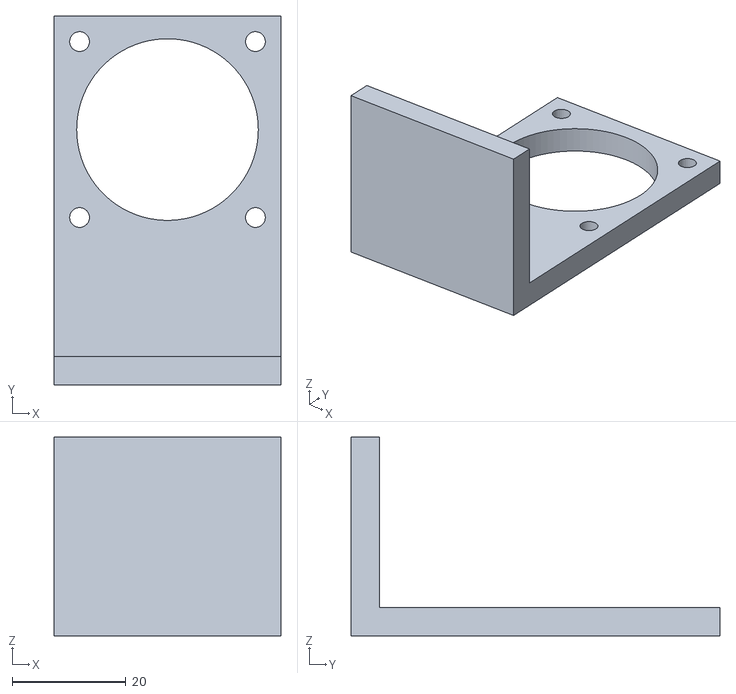
[picture p34: CAD file, 2023-09-04]
plotter-frame/Stepper Motor Mount v1.stl
40.0 x 65.0 x 35.0
