accellarando/TagGang/(list of files, cad)

Other CAD files:
plotter-frame/gondola-3.stl
plotter-frame/stepper-motor-mount-fin-2.stl
plotter-frame/stl/StepperMotorMount_1_v2.stl
plotter-frame/Stepper+Motor+Mount+1.stl
hardware/PiHAT-v1.2.f3z
hardware/PiHat-v1.1.f3z
