accellarando/TagGang/hardware/Schematic-v1.3.pdf

# 16 RN2

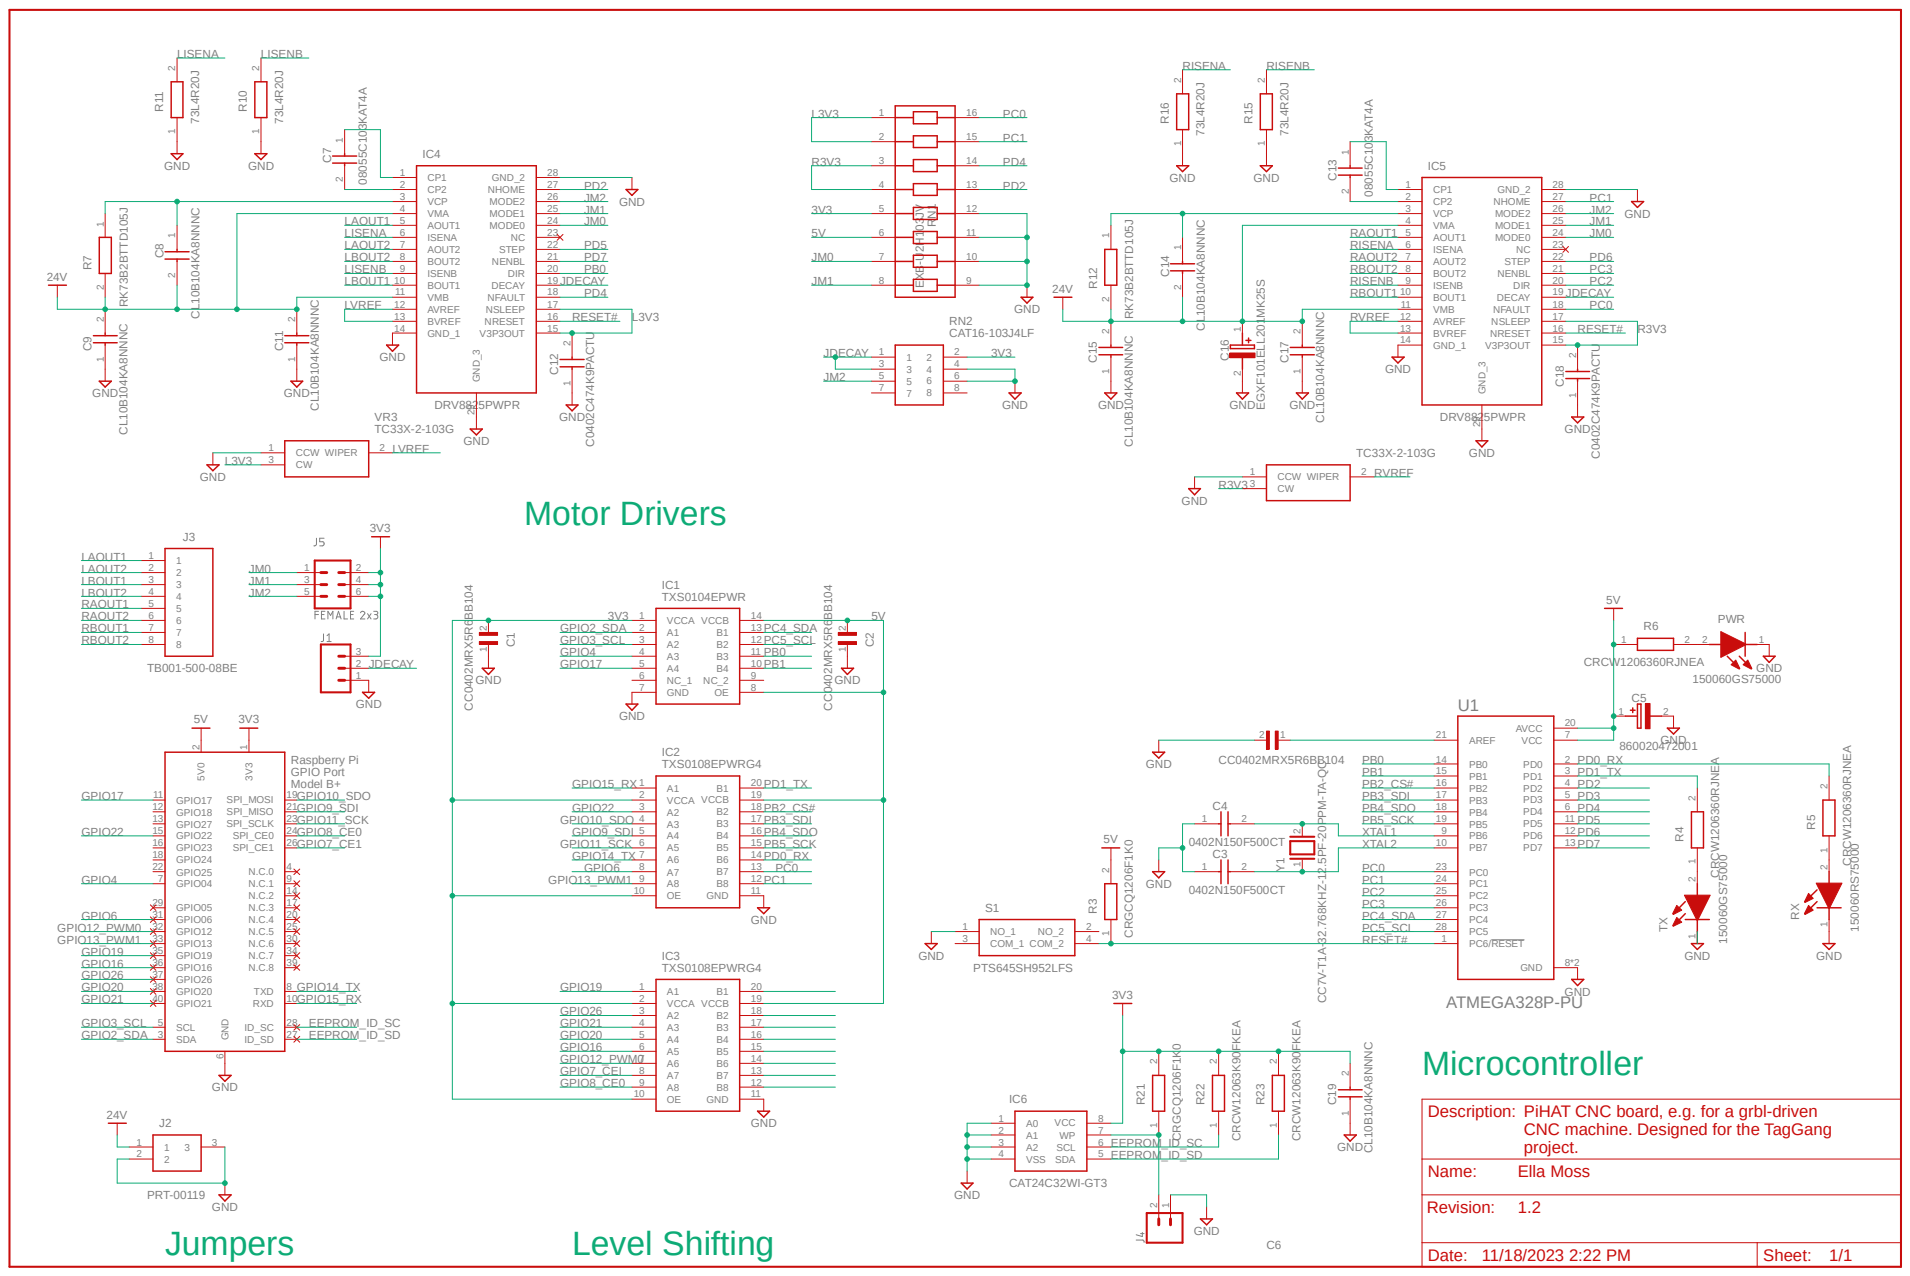
[picture p35: page 1]

6 SDA 3 SCL 5 GPIO17 11 GPIO18 12 GPIO27 13 GPIO22 15 GPIO23 16 GPIO24 18 GPIO25 22 GPIO04 7 TXD 8 RXD 10 SPI_MOSI 19 SPI_MISO 21 SPI_SCLK 23 SPI_CE0 24 SPI_CE1 26 N.C.0 4 N.C.1 9 N.C.2 14 N.C.3 17 N.C.4 20 N.C.5 25

Description: PiHAT CNC board, e.g. for a grbl-driven

CNC machine. Designed for the TagGang
project.
