accellarando/TagGang/hardware/Board-v1.3.pdf

# 3V3 WP C¹

# IC3 IC6 PWR

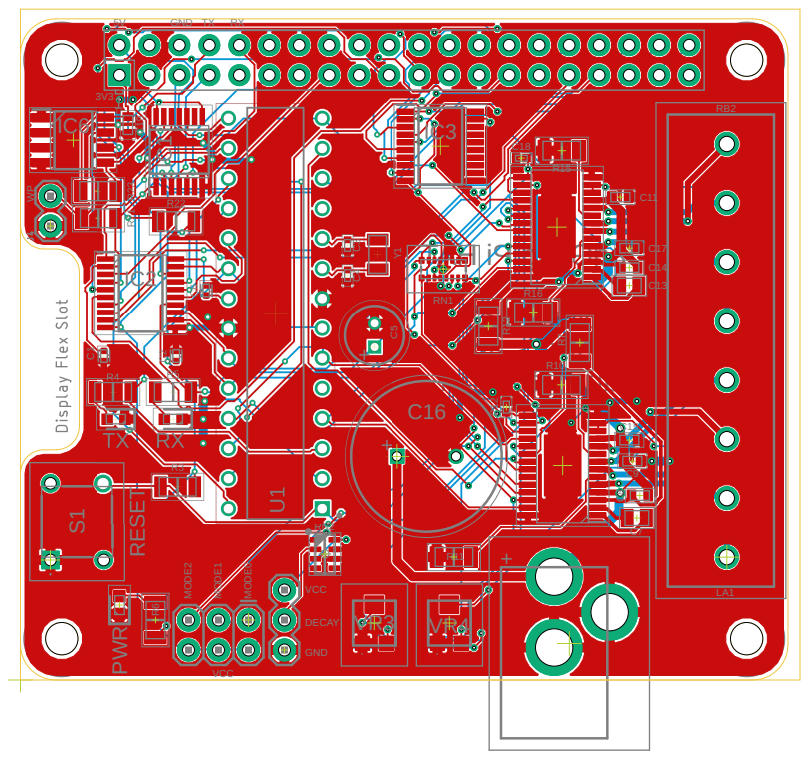
[picture p36: page 1]
