accellarando/TagGang/hardware/Board-v1.1.pdf

# 3V3 WP C¹

# IC3 IC6 PWR

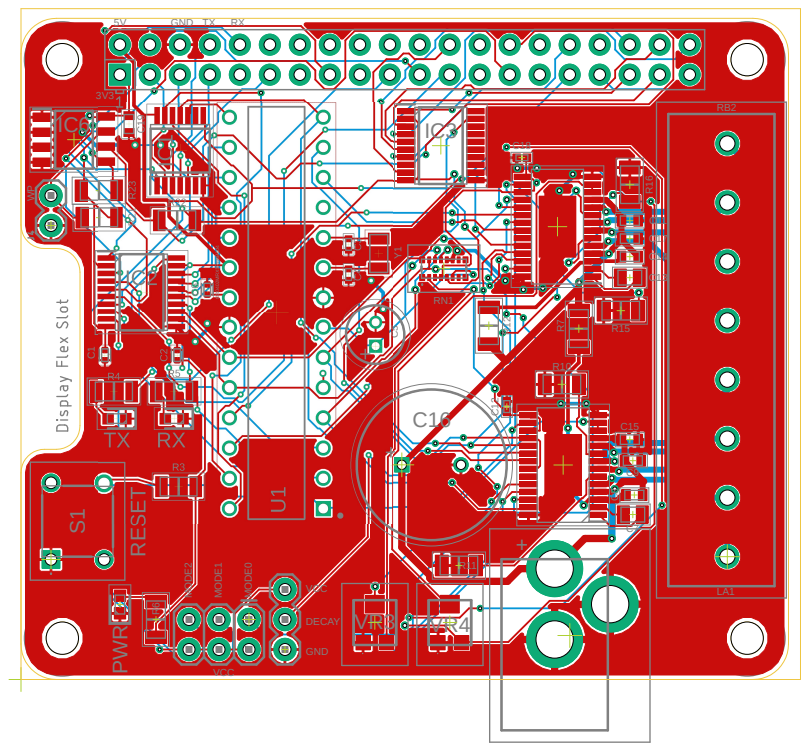
[picture p37: page 1]
