accellarando/TagGang/hardware/Board-v1.3.brd

## EAGLE design hardware/Board-v1.3.brd (2023-09-06)

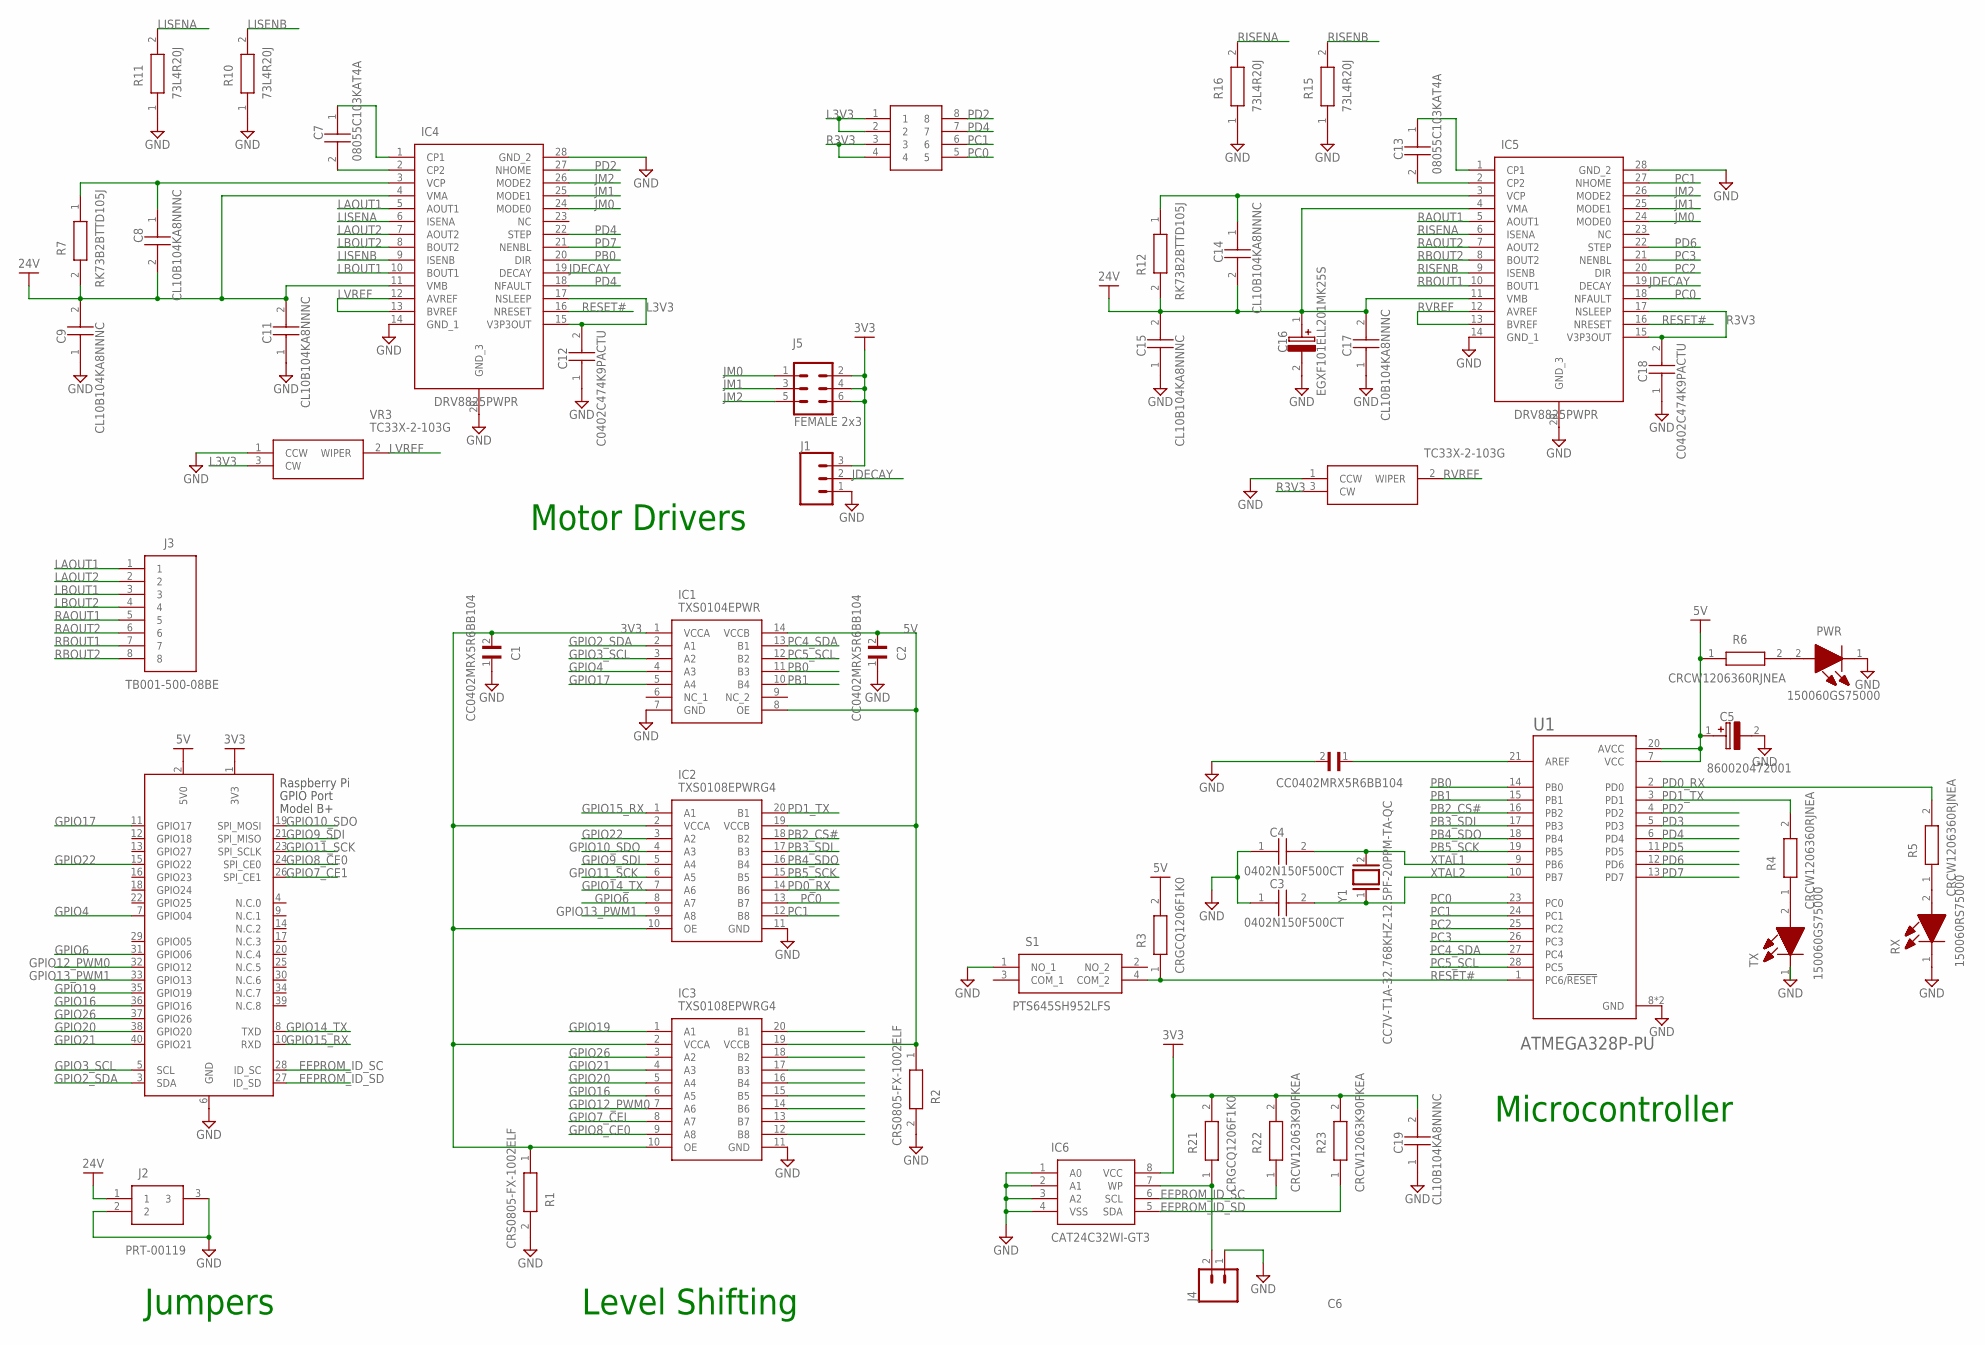
[picture p38: schematic Schematic-v1.1.sch]

Parts:
C1, C2, C6: CC0402MRX5R6BB104; CAPC1005X55N
C3, C4: 0402N150F500CT; CAPC1005X55N
C5: 860020472001; CAPPRD200W52D500H1250
C7, C13: 08055C103KAT4A; CAPC2012X94N
C8, C9, C11, C14, C15, C17, C19: CL10B104KA8NNNC; CAPC1608X90N
C12, C18: C0402C474K9PACTU; CAPC1005X55N
C16: EGXF101ELL201MK25S; CAPPRD500W60D1275H2650
IC1: TXS0104EPWR; SOP65P640X120-14N
IC2, IC3: TXS0108EPWRG4; SOP65P640X120-20N
IC4, IC5: DRV8825PWPR; SOP65P640X120-29N
IC6: CAT24C32WI-GT3; SOIC127P600X175-8N
J1: CONN_03; 1X03
J2: PRT-00119; PRT00119
J3: TB001-500-08BE; TB00150008BE
J4: CONN_02; 1X02
J5: FEMALE 2x3; 2X3
PWR: 150060GS75000; LEDC1608X80N
R1, R2: CRS0805-FX-1002ELF; RESC2012X60N
R3, R21: CRGCQ1206F1K0; RESC3116X65N
R4, R5, R6: CRCW1206360RJNEA; RESC3216X60N
R7, R12: RK73B2BTTD105J; RESC3216X70N
R10, R11, R15, R16: 73L4R20J; RESC3216X70N
R22, R23: CRCW12063K90FKEA; RESC3216X60N
RN1: YC124-JR-0710KL; YC124JR0710KL
RX: 150060RS75000; LEDC1608X80N
S1: PTS645SH952LFS
TX: 150060GS75000; LEDC1608X80N
U1: ATMEGA328P-PU; DIP794W46P254L2967H457Q28B
VR3, VR4: TC33X-2-103G; TC33X2503E
X1: RASPI_BOARD_B+_HD; RASPI_BOARD_B+HAT_DF
Y1: CC7V-T1A-32.768KHZ-12.5PF-20PPM-TA-QC; XTAL_CC7V-T1A-32.768KHZ-12.5PF-20PPM-TA-QC

Connections:
24V: C8.2, C9.2, C11.2, C14.2, C15.2, C16.1 (+), C17.2, IC4.4 (VMA), IC4.11 (VMB), IC5.4 (VMA), IC5.11 (VMB), J2.1, R7.2, R12.2
EEPROM_ID_SC: IC6.6 (SCL), R22.1, X1.28 (ID_SC)
EEPROM_ID_SD: IC6.5 (SDA), R23.1, X1.27 (ID_SD)
GND: C1.1, C2.1, C3.1, C4.1, C5.2 (-), C6.2, C9.1, C11.1, C12.1, C15.1, C16.2 (-), C17.1, C18.1, C19.1, IC1.7 (GND), IC2.11 (GND), IC3.11 (GND), IC4.14 (GND_1), IC4.28 (GND_2), IC4.29 (GND_3), IC5.14 (GND_1), IC5.28 (GND_2), IC5.29 (GND_3), IC6.1 (A0), IC6.2 (A1), IC6.3 (A2), IC6.4 (VSS), J1.1, J2.2, J2.3, J4.1, PWR.1 (K), R1.2, R2.2, R10.1, R11.1, R15.1, R16.1, RX.1 (K), S1.1 (NO_1), TX.1 (K), U1.8 (GND), U1.22 (GND), VR3.1 (CCW), VR4.1 (CCW), X1.6 (GND); also elsewhere on the board
GPIO2_SDA: IC1.2 (A1), X1.3 (SDA)
GPIO3_SCL: IC1.3 (A2), X1.5 (SCL)
GPIO4: IC1.4 (A3), X1.7 (GPIO04)
GPIO6: IC2.8 (A7), X1.31 (GPIO06)
GPIO7_CE1: X1.26 (SPI_CE1)
GPIO7_CEI: IC3.8 (A7)
GPIO8_CE0: IC3.9 (A8), X1.24 (SPI_CE0)
GPIO9_SDI: IC2.5 (A4), X1.21 (SPI_MISO)
GPIO10_SDO: IC2.4 (A3), X1.19 (SPI_MOSI)
GPIO11_SCK: IC2.6 (A5), X1.23 (SPI_SCLK)
GPIO12_PWM0: IC3.7 (A6), X1.32 (GPIO12)
GPIO13_PWM1: IC2.9 (A8), X1.33 (GPIO13)
GPIO14_TX: IC2.7 (A6), X1.8 (TXD)
GPIO15_RX: IC2.1 (A1), X1.10 (RXD)
GPIO16: IC3.6 (A5), X1.36 (GPIO16)
GPIO17: IC1.5 (A4), X1.11 (GPIO17)
GPIO19: IC3.1 (A1), X1.35 (GPIO19)
GPIO20: IC3.5 (A4), X1.38 (GPIO20)
GPIO21: IC3.4 (A3), X1.40 (GPIO21)
GPIO22: IC2.3 (A2), X1.15 (GPIO22)
GPIO26: IC3.3 (A2), X1.37 (GPIO26)
JDECAY: IC4.19 (DECAY), IC5.19 (DECAY), J1.2; also elsewhere on the board
JM2: IC4.26 (MODE2), IC5.26 (MODE2), J5.5; also elsewhere on the board
L3V3: C12.2, IC4.15 (V3P3OUT), IC4.17 (NSLEEP), RN1.1, RN1.2, VR3.3 (CW)
LAOUT1: IC4.5 (AOUT1), J3.1
LAOUT2: IC4.7 (AOUT2), J3.2
LBOUT1: IC4.10 (BOUT1), J3.3
LBOUT2: IC4.8 (BOUT2), J3.4
LISENA: IC4.6 (ISENA), R11.2
LISENB: IC4.9 (ISENB), R10.2
LVREF: IC4.12 (AVREF), IC4.13 (BVREF), VR3.2 (WIPER)
unnamed: C13.1, IC5.1 (CP1)
unnamed: R5.1, RX.2 (A)
unnamed: PWR.2 (A), R6.2
unnamed: C6.1, U1.21 (AREF)
unnamed: C7.1, IC4.1 (CP1)
unnamed: C7.2, IC4.2 (CP2)
unnamed: C13.2, IC5.2 (CP2)
unnamed: C8.1, IC4.3 (VCP), R7.1
unnamed: C14.1, IC5.3 (VCP), R12.1
unnamed: R4.1, TX.2 (A)
unnamed: IC6.7 (WP), J4.2, R21.1
PB0: IC1.11 (B3), IC4.20 (DIR), U1.14 (PB0)
PB1: IC1.10 (B4), U1.15 (PB1)
PB2_CS#: IC2.18 (B2), U1.16 (PB2)
PB3_SDI: IC2.17 (B3), U1.17 (PB3)
PB4_SDO: IC2.16 (B4), U1.18 (PB4)
PB5_SCK: IC2.15 (B5), U1.19 (PB5)
PC2: IC5.20 (DIR), U1.25 (PC2)
PC3: IC5.21 (NENBL), U1.26 (PC3)
PC4_SDA: IC1.13 (B1), U1.27 (PC4)
PC5_SCL: IC1.12 (B2), U1.28 (PC5)
PD0_RX: IC2.14 (B6), R5.2, U1.2 (PD0)
PD1_TX: IC2.20 (B1), R4.2, U1.3 (PD1)
PD3: U1.5 (PD3)
PD5: U1.11 (PD5)
PD6: IC5.22 (STEP), U1.12 (PD6)
PD7: IC4.21 (NENBL), U1.13 (PD7)
R3V3: C18.2, IC5.15 (V3P3OUT), IC5.17 (NSLEEP), RN1.3, RN1.4, VR4.3 (CW)
RAOUT1: IC5.5 (AOUT1), J3.5
RAOUT2: IC5.7 (AOUT2), J3.6
RBOUT1: IC5.10 (BOUT1), J3.7
RBOUT2: IC5.8 (BOUT2), J3.8
RESET#: IC4.16 (NRESET), IC5.16 (NRESET), R3.1, S1.4 (COM_2), U1.1 (PC6/!RESET)
RISENA: IC5.6 (ISENA), R16.2
RISENB: IC5.9 (ISENB), R15.2
RVREF: IC5.12 (AVREF), IC5.13 (BVREF), VR4.2 (WIPER)
XTAL1: C4.2, U1.9 (PB6), Y1.2
XTAL2: C3.2, U1.10 (PB7), Y1.1

Notes on the sheet:
Jumpers
Level Shifting
Microcontroller
Motor Drivers

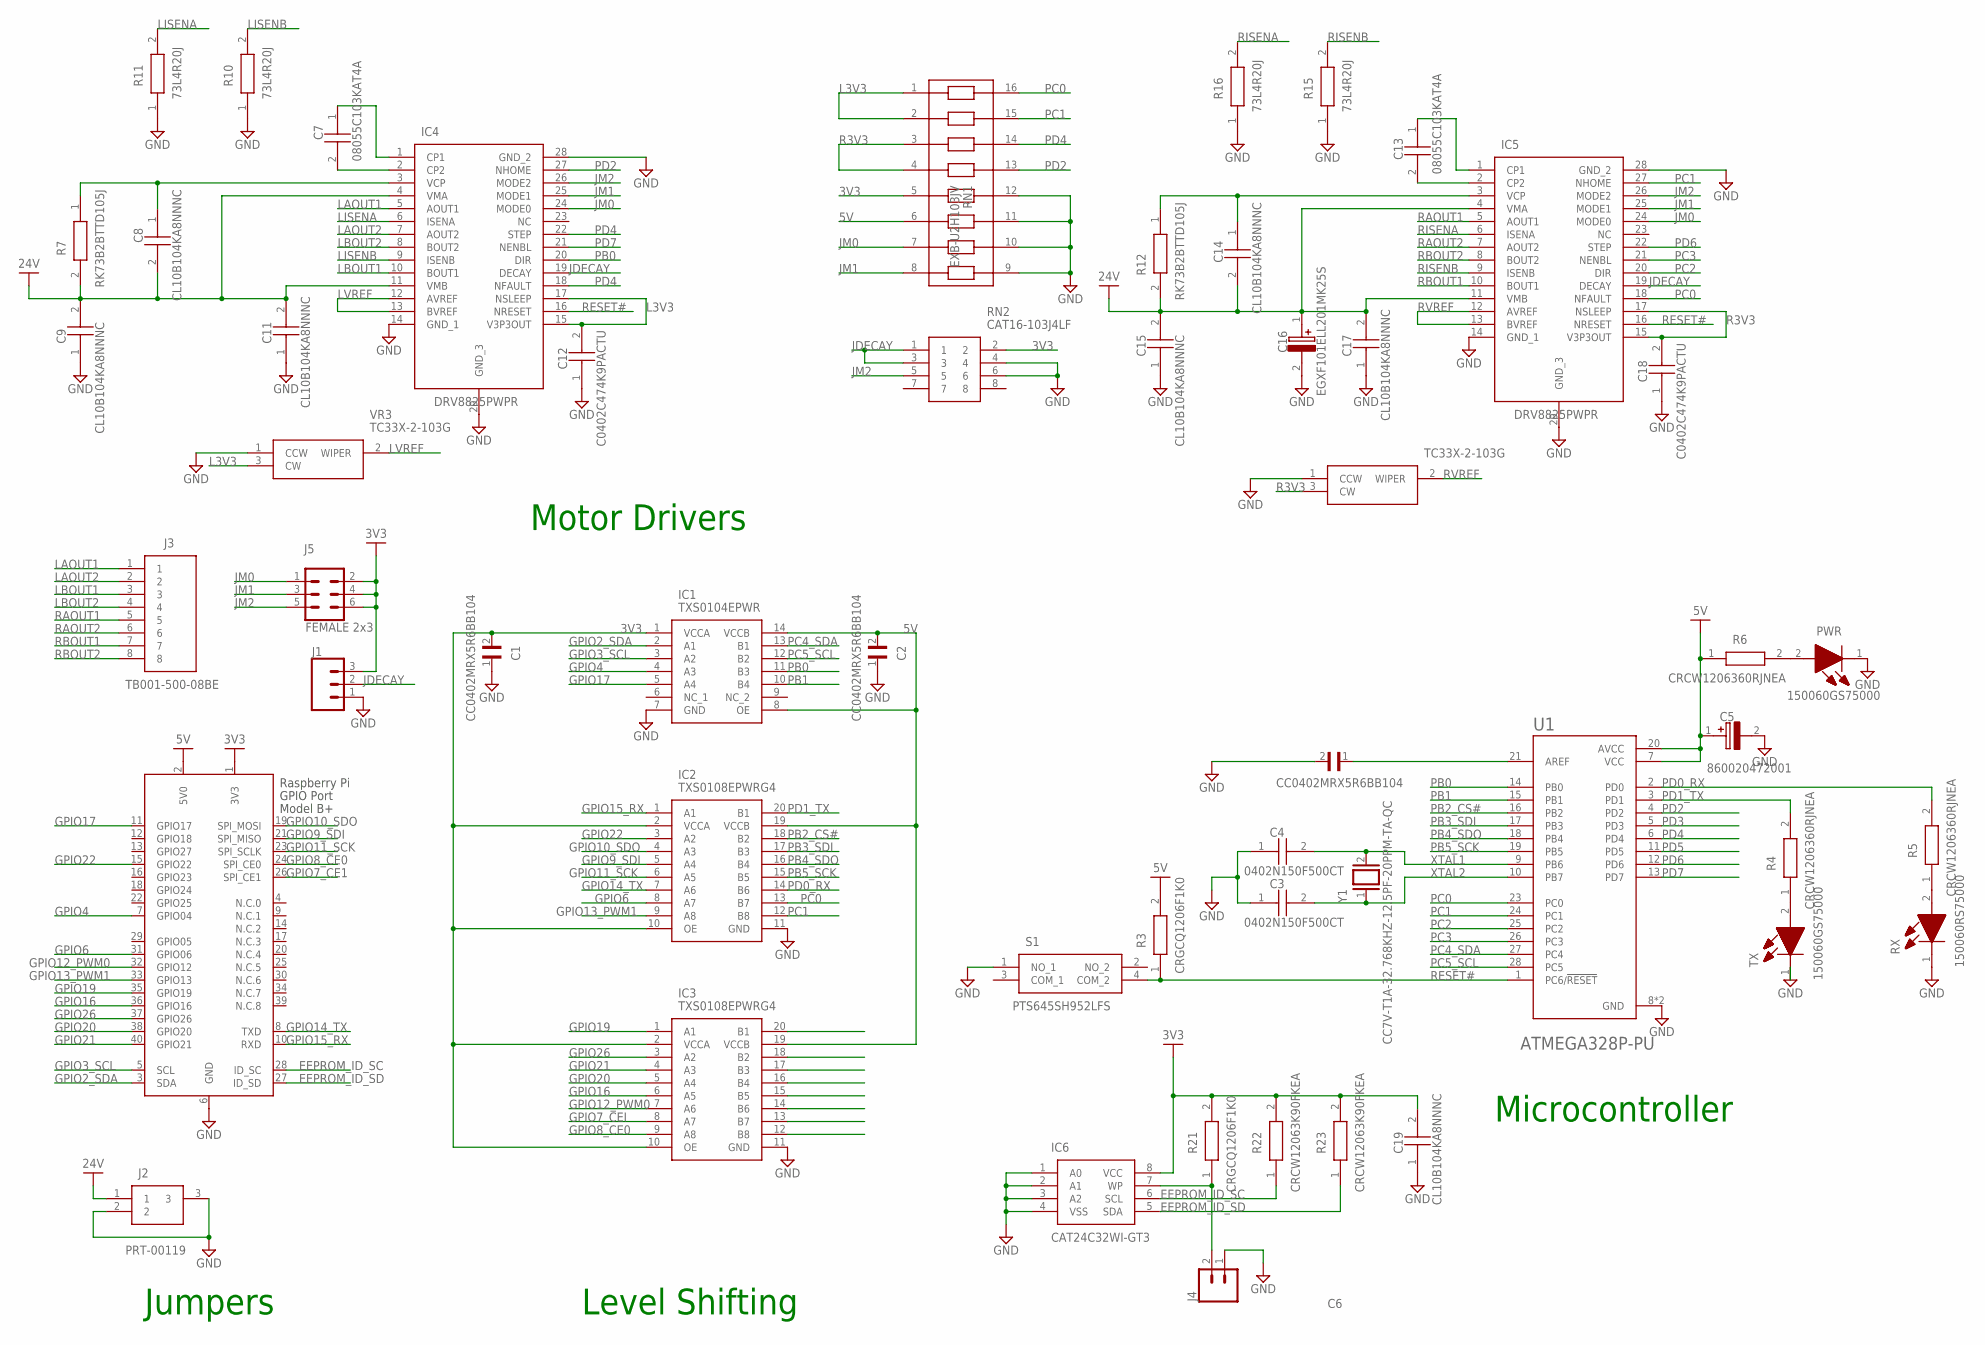
[picture p39: schematic Schematic-v1.2.sch]

Parts:
C1, C2, C6: CC0402MRX5R6BB104; CAPC1005X55N
C3, C4: 0402N150F500CT; CAPC1005X55N
C5: 860020472001; CAPPRD200W52D500H1250
C7, C13: 08055C103KAT4A; CAPC2012X94N
C8, C9, C11, C14, C15, C17, C19: CL10B104KA8NNNC; CAPC1608X90N
C12, C18: C0402C474K9PACTU; CAPC1005X55N
C16: EGXF101ELL201MK25S; CAPPRD500W60D1275H2650
IC1: TXS0104EPWR; SOP65P640X120-14N
IC2, IC3: TXS0108EPWRG4; SOP65P640X120-20N
IC4, IC5: DRV8825PWPR; SOP65P640X120-29N
IC6: CAT24C32WI-GT3; SOIC127P600X175-8N
J1: CONN_03; 1X03
J2: PRT-00119; PRT00119
J3: TB001-500-08BE; TB00150008BE
J4: CONN_02; 1X02
J5: FEMALE 2x3; 2X3
PWR: 150060GS75000; LEDC1608X80N
R3, R21: CRGCQ1206F1K0; RESC3116X65N
R4, R5, R6: CRCW1206360RJNEA; RESC3216X60N
R7, R12: RK73B2BTTD105J; RESC3216X70N
R10, R11, R15, R16: 73L4R20J; RESC3216X70N
R22, R23: CRCW12063K90FKEA; RESC3216X60N
RN1: EXB-U2H103JV; EXBU2H
RN2: CAT16-103J4LF; CAPCAV80P155X320X60-8L
RX: 150060RS75000; LEDC1608X80N
S1: PTS645SH952LFS
TX: 150060GS75000; LEDC1608X80N
U1: ATMEGA328P-PU; DIP794W46P254L2967H457Q28B
VR3, VR4: TC33X-2-103G; TC33X2503E
X1: RASPI_BOARD_B+_HD; RASPI_BOARD_B+HAT_DF
Y1: CC7V-T1A-32.768KHZ-12.5PF-20PPM-TA-QC; XTAL_CC7V-T1A-32.768KHZ-12.5PF-20PPM-TA-QC

Connections:
24V: C8.2, C9.2, C11.2, C14.2, C15.2, C16.1 (+), C17.2, IC4.4 (VMA), IC4.11 (VMB), IC5.4 (VMA), IC5.11 (VMB), J2.1, R7.2, R12.2
EEPROM_ID_SC: IC6.6 (SCL), R22.1, X1.28 (ID_SC)
EEPROM_ID_SD: IC6.5 (SDA), R23.1, X1.27 (ID_SD)
GND: C1.1, C2.1, C3.1, C4.1, C5.2 (-), C6.2, C9.1, C11.1, C12.1, C15.1, C16.2 (-), C17.1, C18.1, C19.1, IC1.7 (GND), IC2.11 (GND), IC3.11 (GND), IC4.14 (GND_1), IC4.28 (GND_2), IC4.29 (GND_3), IC5.14 (GND_1), IC5.28 (GND_2), IC5.29 (GND_3), IC6.1 (A0), IC6.2 (A1), IC6.3 (A2), IC6.4 (VSS), J1.1, J2.2, J2.3, J4.1, PWR.1 (K), R10.1, R11.1, R15.1, R16.1, RN1.9, RN1.10, RN1.11, RN1.12, RN2.4, RN2.6, RX.1 (K), S1.1 (NO_1), TX.1 (K), U1.8 (GND), U1.22 (GND), VR3.1 (CCW), VR4.1 (CCW), X1.6 (GND); also elsewhere on the board
GPIO2_SDA: IC1.2 (A1), X1.3 (SDA)
GPIO3_SCL: IC1.3 (A2), X1.5 (SCL)
GPIO4: IC1.4 (A3), X1.7 (GPIO04)
GPIO6: IC2.8 (A7), X1.31 (GPIO06)
GPIO7_CE1: X1.26 (SPI_CE1)
GPIO7_CEI: IC3.8 (A7)
GPIO8_CE0: IC3.9 (A8), X1.24 (SPI_CE0)
GPIO9_SDI: IC2.5 (A4), X1.21 (SPI_MISO)
GPIO10_SDO: IC2.4 (A3), X1.19 (SPI_MOSI)
GPIO11_SCK: IC2.6 (A5), X1.23 (SPI_SCLK)
GPIO12_PWM0: IC3.7 (A6), X1.32 (GPIO12)
GPIO13_PWM1: IC2.9 (A8), X1.33 (GPIO13)
GPIO14_TX: IC2.7 (A6), X1.8 (TXD)
GPIO15_RX: IC2.1 (A1), X1.10 (RXD)
GPIO16: IC3.6 (A5), X1.36 (GPIO16)
GPIO17: IC1.5 (A4), X1.11 (GPIO17)
GPIO19: IC3.1 (A1), X1.35 (GPIO19)
GPIO20: IC3.5 (A4), X1.38 (GPIO20)
GPIO21: IC3.4 (A3), X1.40 (GPIO21)
GPIO22: IC2.3 (A2), X1.15 (GPIO22)
GPIO26: IC3.3 (A2), X1.37 (GPIO26)
JDECAY: IC4.19 (DECAY), IC5.19 (DECAY), J1.2, RN2.1, RN2.3
JM2: IC4.26 (MODE2), IC5.26 (MODE2), J5.5, RN2.5
L3V3: C12.2, IC4.15 (V3P3OUT), IC4.17 (NSLEEP), RN1.1, RN1.2, VR3.3 (CW)
LAOUT1: IC4.5 (AOUT1), J3.1
LAOUT2: IC4.7 (AOUT2), J3.2
LBOUT1: IC4.10 (BOUT1), J3.3
LBOUT2: IC4.8 (BOUT2), J3.4
LISENA: IC4.6 (ISENA), R11.2
LISENB: IC4.9 (ISENB), R10.2
LVREF: IC4.12 (AVREF), IC4.13 (BVREF), VR3.2 (WIPER)
unnamed: C13.1, IC5.1 (CP1)
unnamed: R5.1, RX.2 (A)
unnamed: PWR.2 (A), R6.2
unnamed: C6.1, U1.21 (AREF)
unnamed: C7.1, IC4.1 (CP1)
unnamed: C7.2, IC4.2 (CP2)
unnamed: C13.2, IC5.2 (CP2)
unnamed: C8.1, IC4.3 (VCP), R7.1
unnamed: C14.1, IC5.3 (VCP), R12.1
unnamed: R4.1, TX.2 (A)
unnamed: IC6.7 (WP), J4.2, R21.1
PB0: IC1.11 (B3), IC4.20 (DIR), U1.14 (PB0)
PB1: IC1.10 (B4), U1.15 (PB1)
PB2_CS#: IC2.18 (B2), U1.16 (PB2)
PB3_SDI: IC2.17 (B3), U1.17 (PB3)
PB4_SDO: IC2.16 (B4), U1.18 (PB4)
PB5_SCK: IC2.15 (B5), U1.19 (PB5)
PC2: IC5.20 (DIR), U1.25 (PC2)
PC3: IC5.21 (NENBL), U1.26 (PC3)
PC4_SDA: IC1.13 (B1), U1.27 (PC4)
PC5_SCL: IC1.12 (B2), U1.28 (PC5)
PD0_RX: IC2.14 (B6), R5.2, U1.2 (PD0)
PD1_TX: IC2.20 (B1), R4.2, U1.3 (PD1)
PD3: U1.5 (PD3)
PD5: U1.11 (PD5)
PD6: IC5.22 (STEP), U1.12 (PD6)
PD7: IC4.21 (NENBL), U1.13 (PD7)
R3V3: C18.2, IC5.15 (V3P3OUT), IC5.17 (NSLEEP), RN1.3, RN1.4, VR4.3 (CW)
RAOUT1: IC5.5 (AOUT1), J3.5
RAOUT2: IC5.7 (AOUT2), J3.6
RBOUT1: IC5.10 (BOUT1), J3.7
RBOUT2: IC5.8 (BOUT2), J3.8
RESET#: IC4.16 (NRESET), IC5.16 (NRESET), R3.1, S1.4 (COM_2), U1.1 (PC6/!RESET)
RISENA: IC5.6 (ISENA), R16.2
RISENB: IC5.9 (ISENB), R15.2
RVREF: IC5.12 (AVREF), IC5.13 (BVREF), VR4.2 (WIPER)
XTAL1: C4.2, U1.9 (PB6), Y1.2
XTAL2: C3.2, U1.10 (PB7), Y1.1

Notes on the sheet:
Jumpers
Level Shifting
Microcontroller
Motor Drivers

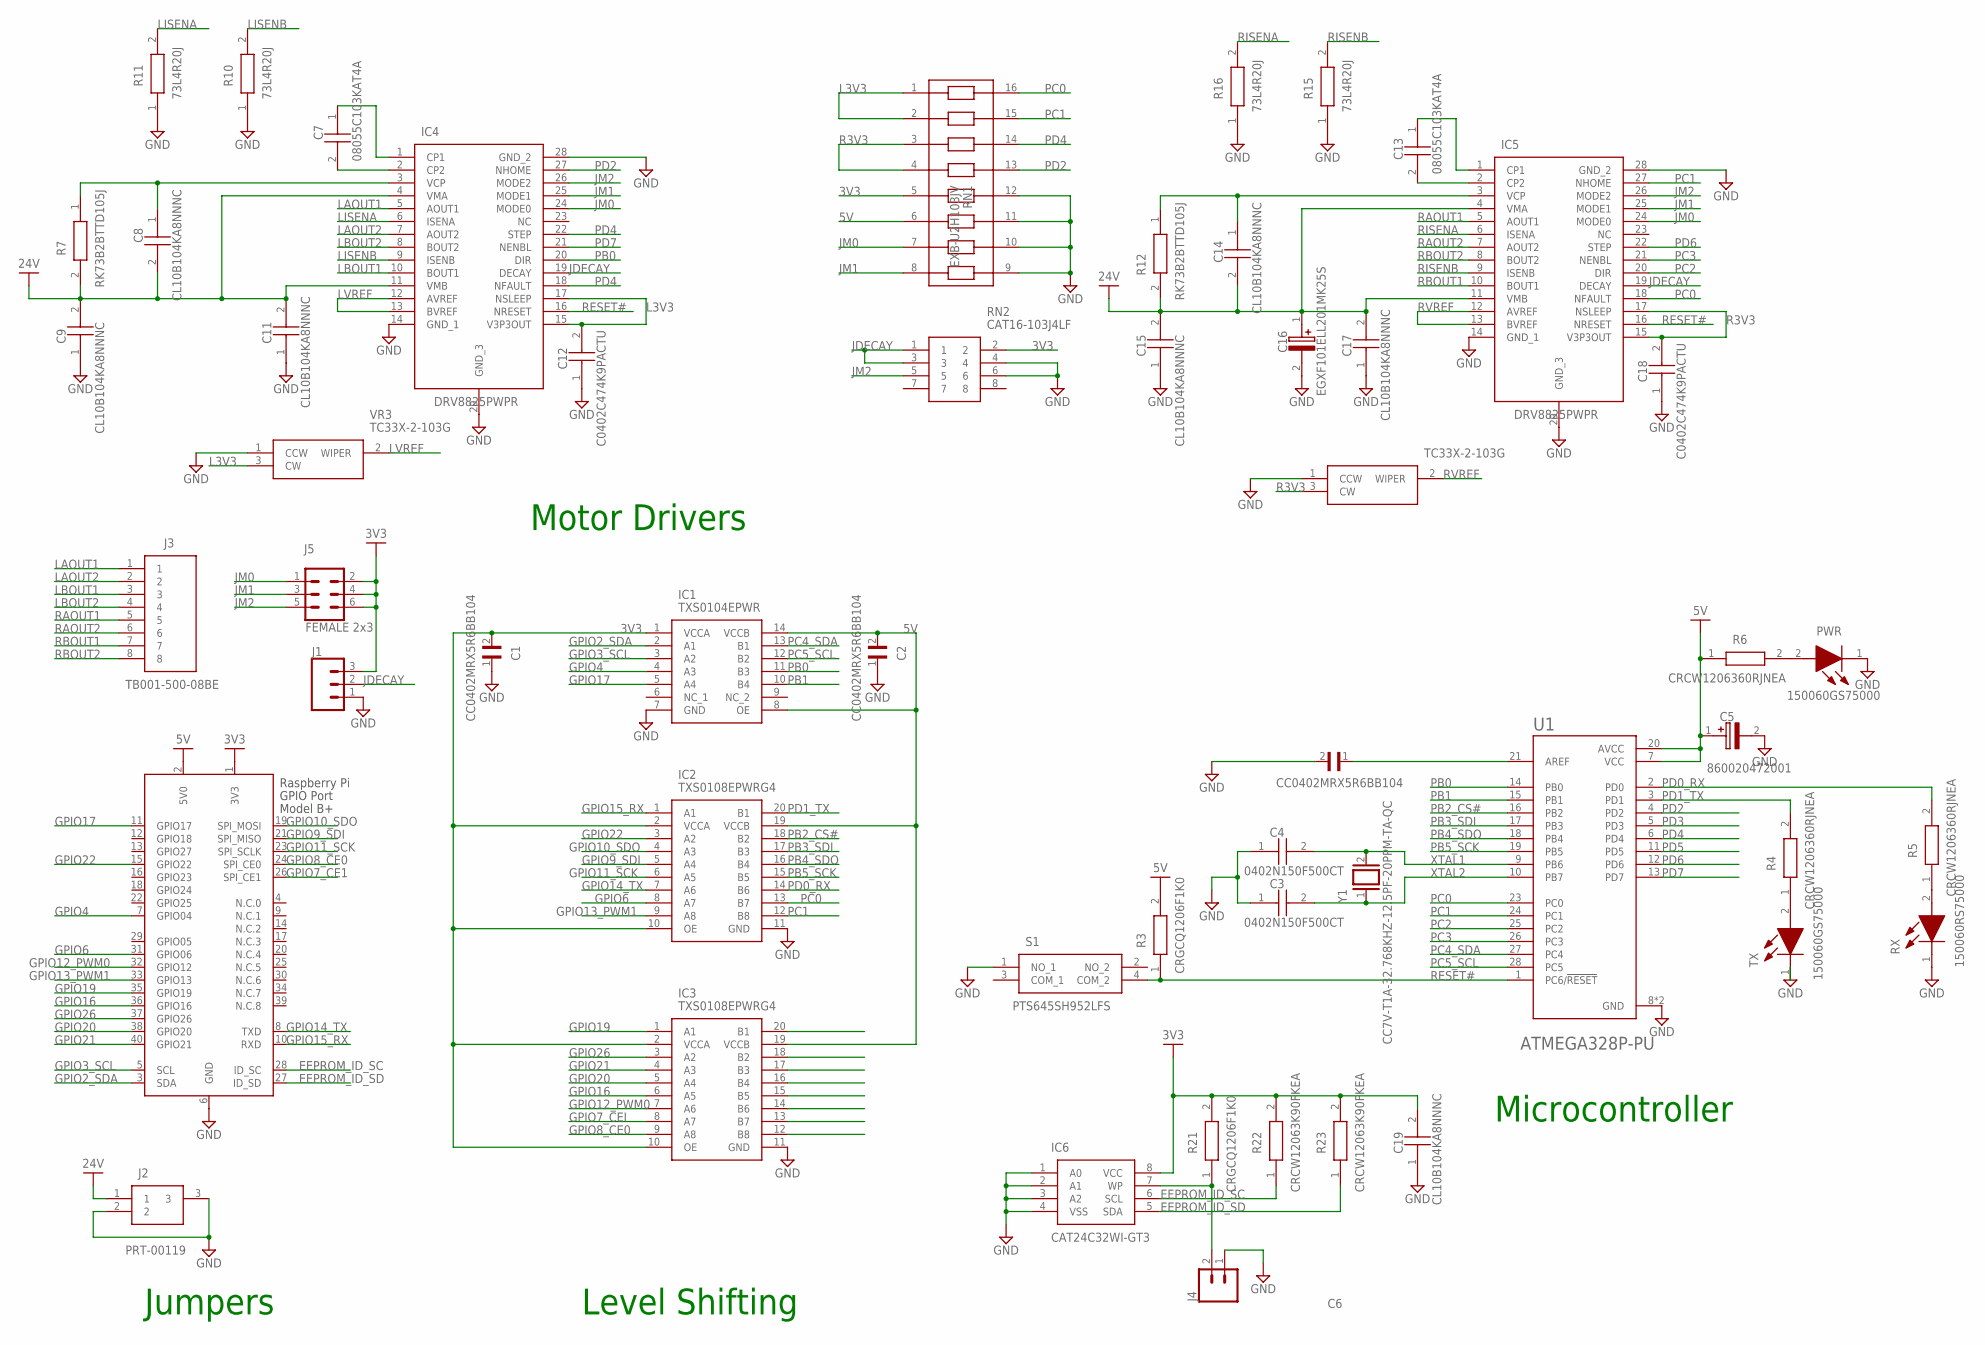
[picture p40: schematic Schematic-v1.3.sch]

Parts:
C1, C2, C6: CC0402MRX5R6BB104; CAPC1005X55N
C3, C4: 0402N150F500CT; CAPC1005X55N
C5: 860020472001; CAPPRD200W52D500H1250
C7, C13: 08055C103KAT4A; CAPC2012X94N
C8, C9, C11, C14, C15, C17, C19: CL10B104KA8NNNC; CAPC1608X90N
C12, C18: C0402C474K9PACTU; CAPC1005X55N
C16: EGXF101ELL201MK25S; CAPPRD500W60D1275H2650
IC1: TXS0104EPWR; SOP65P640X120-14N
IC2, IC3: TXS0108EPWRG4; SOP65P640X120-20N
IC4, IC5: DRV8825PWPR; SOP65P640X120-29N
IC6: CAT24C32WI-GT3; SOIC127P600X175-8N
J1: CONN_03; 1X03
J2: PRT-00119; PRT00119
J3: TB001-500-08BE; TB00150008BE
J4: CONN_02; 1X02
J5: FEMALE 2x3; 2X3
PWR: 150060GS75000; LEDC1608X80N
R3, R21: CRGCQ1206F1K0; RESC3116X65N
R4, R5, R6: CRCW1206360RJNEA; RESC3216X60N
R7, R12: RK73B2BTTD105J; RESC3216X70N
R10, R11, R15, R16: 73L4R20J; RESC3216X70N
R22, R23: CRCW12063K90FKEA; RESC3216X60N
RN1: EXB-U2H103JV; EXBU2H
RN2: CAT16-103J4LF; CAPCAV80P155X320X60-8L
RX: 150060RS75000; LEDC1608X80N
S1: PTS645SH952LFS
TX: 150060GS75000; LEDC1608X80N
U1: ATMEGA328P-PU; DIP794W46P254L2967H457Q28B
VR3, VR4: TC33X-2-103G; TC33X2503E
X1: RASPI_BOARD_B+_HD; RASPI_BOARD_B+HAT_DF
Y1: CC7V-T1A-32.768KHZ-12.5PF-20PPM-TA-QC; XTAL_CC7V-T1A-32.768KHZ-12.5PF-20PPM-TA-QC

Connections:
24V: C8.2, C9.2, C11.2, C14.2, C15.2, C16.1 (+), C17.2, IC4.4 (VMA), IC4.11 (VMB), IC5.4 (VMA), IC5.11 (VMB), J2.1, R7.2, R12.2
EEPROM_ID_SC: IC6.6 (SCL), R22.1, X1.28 (ID_SC)
EEPROM_ID_SD: IC6.5 (SDA), R23.1, X1.27 (ID_SD)
GND: C1.1, C2.1, C3.1, C4.1, C5.2 (-), C6.2, C9.1, C11.1, C12.1, C15.1, C16.2 (-), C17.1, C18.1, C19.1, IC1.7 (GND), IC2.11 (GND), IC3.11 (GND), IC4.14 (GND_1), IC4.28 (GND_2), IC4.29 (GND_3), IC5.14 (GND_1), IC5.28 (GND_2), IC5.29 (GND_3), IC6.1 (A0), IC6.2 (A1), IC6.3 (A2), IC6.4 (VSS), J1.1, J2.2, J2.3, J4.1, PWR.1 (K), R10.1, R11.1, R15.1, R16.1, RN1.9, RN1.10, RN1.11, RN1.12, RN2.4, RN2.6, RX.1 (K), S1.1 (NO_1), TX.1 (K), U1.8 (GND), U1.22 (GND), VR3.1 (CCW), VR4.1 (CCW), X1.6 (GND); also elsewhere on the board
GPIO2_SDA: IC1.2 (A1), X1.3 (SDA)
GPIO3_SCL: IC1.3 (A2), X1.5 (SCL)
GPIO4: IC1.4 (A3), X1.7 (GPIO04)
GPIO6: IC2.8 (A7), X1.31 (GPIO06)
GPIO7_CE1: X1.26 (SPI_CE1)
GPIO7_CEI: IC3.8 (A7)
GPIO8_CE0: IC3.9 (A8), X1.24 (SPI_CE0)
GPIO9_SDI: IC2.5 (A4), X1.21 (SPI_MISO)
GPIO10_SDO: IC2.4 (A3), X1.19 (SPI_MOSI)
GPIO11_SCK: IC2.6 (A5), X1.23 (SPI_SCLK)
GPIO12_PWM0: IC3.7 (A6), X1.32 (GPIO12)
GPIO13_PWM1: IC2.9 (A8), X1.33 (GPIO13)
GPIO14_TX: IC2.7 (A6), X1.8 (TXD)
GPIO15_RX: IC2.1 (A1), X1.10 (RXD)
GPIO16: IC3.6 (A5), X1.36 (GPIO16)
GPIO17: IC1.5 (A4), X1.11 (GPIO17)
GPIO19: IC3.1 (A1), X1.35 (GPIO19)
GPIO20: IC3.5 (A4), X1.38 (GPIO20)
GPIO21: IC3.4 (A3), X1.40 (GPIO21)
GPIO22: IC2.3 (A2), X1.15 (GPIO22)
GPIO26: IC3.3 (A2), X1.37 (GPIO26)
JDECAY: IC4.19 (DECAY), IC5.19 (DECAY), J1.2, RN2.1, RN2.3
JM2: IC4.26 (MODE2), IC5.26 (MODE2), J5.5, RN2.5
L3V3: C12.2, IC4.15 (V3P3OUT), IC4.17 (NSLEEP), RN1.1, RN1.2, VR3.3 (CW)
LAOUT1: IC4.5 (AOUT1), J3.1
LAOUT2: IC4.7 (AOUT2), J3.2
LBOUT1: IC4.10 (BOUT1), J3.3
LBOUT2: IC4.8 (BOUT2), J3.4
LISENA: IC4.6 (ISENA), R11.2
LISENB: IC4.9 (ISENB), R10.2
LVREF: IC4.12 (AVREF), IC4.13 (BVREF), VR3.2 (WIPER)
unnamed: C13.1, IC5.1 (CP1)
unnamed: R5.1, RX.2 (A)
unnamed: PWR.2 (A), R6.2
unnamed: C6.1, U1.21 (AREF)
unnamed: C7.1, IC4.1 (CP1)
unnamed: C7.2, IC4.2 (CP2)
unnamed: C13.2, IC5.2 (CP2)
unnamed: C8.1, IC4.3 (VCP), R7.1
unnamed: C14.1, IC5.3 (VCP), R12.1
unnamed: R4.1, TX.2 (A)
unnamed: IC6.7 (WP), J4.2, R21.1
PB0: IC1.11 (B3), IC4.20 (DIR), U1.14 (PB0)
PB1: IC1.10 (B4), U1.15 (PB1)
PB2_CS#: IC2.18 (B2), U1.16 (PB2)
PB3_SDI: IC2.17 (B3), U1.17 (PB3)
PB4_SDO: IC2.16 (B4), U1.18 (PB4)
PB5_SCK: IC2.15 (B5), U1.19 (PB5)
PC2: IC5.20 (DIR), U1.25 (PC2)
PC3: IC5.21 (NENBL), U1.26 (PC3)
PC4_SDA: IC1.13 (B1), U1.27 (PC4)
PC5_SCL: IC1.12 (B2), U1.28 (PC5)
PD0_RX: IC2.14 (B6), R5.2, U1.2 (PD0)
PD1_TX: IC2.20 (B1), R4.2, U1.3 (PD1)
PD3: U1.5 (PD3)
PD5: U1.11 (PD5)
PD6: IC5.22 (STEP), U1.12 (PD6)
PD7: IC4.21 (NENBL), U1.13 (PD7)
R3V3: C18.2, IC5.15 (V3P3OUT), IC5.17 (NSLEEP), RN1.3, RN1.4, VR4.3 (CW)
RAOUT1: IC5.5 (AOUT1), J3.5
RAOUT2: IC5.7 (AOUT2), J3.6
RBOUT1: IC5.10 (BOUT1), J3.7
RBOUT2: IC5.8 (BOUT2), J3.8
RESET#: IC4.16 (NRESET), IC5.16 (NRESET), R3.1, S1.4 (COM_2), U1.1 (PC6/!RESET)
RISENA: IC5.6 (ISENA), R16.2
RISENB: IC5.9 (ISENB), R15.2
RVREF: IC5.12 (AVREF), IC5.13 (BVREF), VR4.2 (WIPER)
XTAL1: C4.2, U1.9 (PB6), Y1.2
XTAL2: C3.2, U1.10 (PB7), Y1.1

Notes on the sheet:
Jumpers
Level Shifting
Microcontroller
Motor Drivers

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
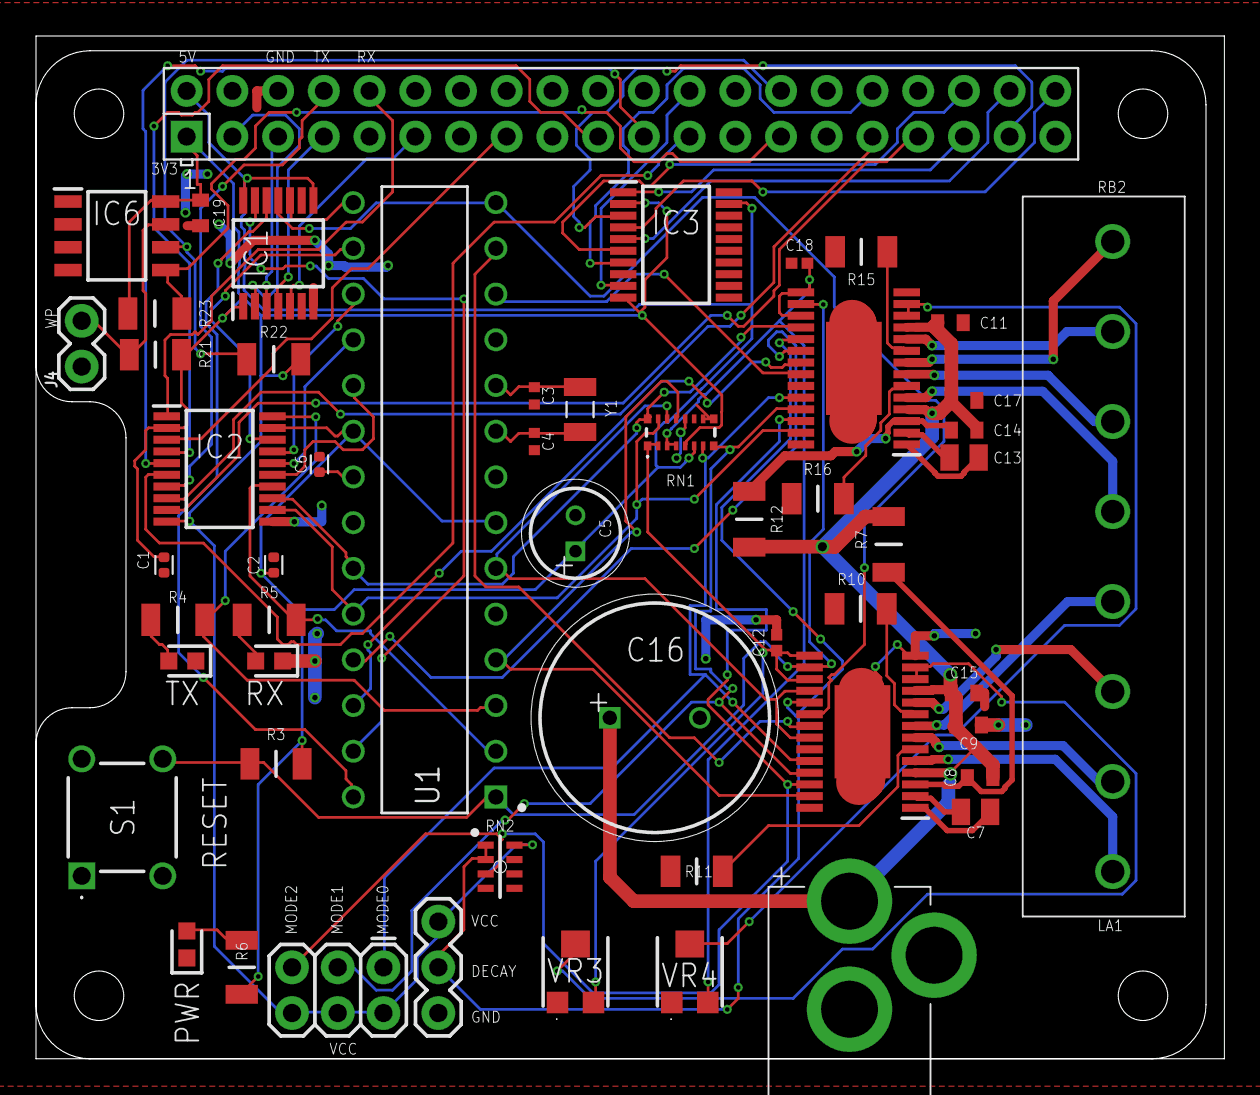
[picture p41: board Board-v1.3.brd from above]

Board: 2 copper layers, 66.0 x 56.8 mm, 53 parts (0 on the bottom side), 77 nets.
