accellarando/TagGang/firmware/main_nucleo/pins.h

// Pins
#define STEP_PIN_L		6
#define DIR_PIN_L		7
#define ENABLE_PIN_L	2
#define CONTROL_PIN_L	5
#define RESET_PIN_L		12

#define STEP_PIN_R		A0
#define DIR_PIN_R		4
#define ENABLE_PIN_R	8
#define CONTROL_PIN_R	A1
#define RESET_PIN_R		13

#define VREFA_PIN_L		3
#define VREFB_PIN_L		9
#define VREFA_PIN_R     10
#define VREFB_PIN_R		11

#define PIN_PEN_SERVO A2

// Stepper motor constants
#define GEAR_RADIUS 4.0 //mm
#define STEPS_PER_REV 200.0
#define PULSES_PER_STEP_L 2.0
#define PULSES_PER_STEP_R 2.0
#define STEPS_PER_MM ( STEPS_PER_REV / (2 * PI * GEAR_RADIUS) )
#define STEPS_R(x) (x*STEPS_PER_MM*PULSES_PER_STEP_R)
#define STEPS_L(x) (x*STEPS_PER_MM*PULSES_PER_STEP_L)
