accellarando/TagGang/software/include/drawable_canvas.h

#ifndef DRAWABLE_CANVAS_H
#define DRAWABLE_CANVAS_H

#include <gtk/gtk.h>
#include <math.h>
#include <main.h>
#include <skeltrack.h>
#include <linux/joystick.h>

// Point structure
typedef struct {
	gdouble x;
	gdouble y;
} DoublePoint;

void activate_canvas (GtkApplication* app, void* i_forgot, gpointer user_data);

GtkWidget* setup_canvas(void);

extern GList* points_list;
extern SkeltrackJointList joints_list;

#endif
