accellarando/TagGang/software/tg_skeltrack.c

/*
 * @brief Kinect source code for TagGang capstone project.
 *
 * This file contains functions to initialize and receive skeleton
 * tracking data from the Kinect.
 *
 * Adapted from https://github.com/joaquimrocha/Skeltrack/blob/master/examples/test-kinect.c.
 *
 * @author Ella Moss
 * @author Dana Escandor
 */

#include <tg_skeltrack.h>
