accellarando/TagGang/software/tg_skeltrack.h

/*
 * @brief Header file for TagGang Kinect code.
 * 
 * @author Ella Moss
 * @author Dana Escandor
 */

#ifndef TG_SKELTRACK_H_ //prevent recursive inclusion
#define TG_SKELTRACK_H_

#include <gfreenect.h>
#include <skeltrack.h>
#include <math.h>
#include <string.h>
#include <stdio.h>
#include <stdlib.h>
#include <unistd.h>
#include <fcntl.h>      // File control definitions
#include <termios.h>    // POSIX terminal control definitions

// Comment this out (or set to 0) to disable Skeltrack debug output.
#define DBG_TG_SKELTRACK 1



#endif
