accellarando/TagGang/(commit log)

2023-03-02 added content to landing page
2023-04-19 added stepperMotor.html for notes on stepper motor progress and info
2023-04-20 additional text to stepperMotor.html notes
2023-04-20 added notes to stepperMotor.html
2023-05-12 added prototypeblockdiagram.png, updated gallery with images
2023-08-17 added schematic pdf
2023-08-19 Hardware v1.1 ready
    [BOM-v1.1.csv, BOM-v1.1.ods, Board-v1.1.brd, PiHat-v1.1.f3z, Schematic-v1.1.sch]
2023-09-04 added stepper motor mount v1 stl and gcode
    [SANMOTION-F2-SF2424-10B11.STEP, Stepper Motor Mount v1.stl]
2023-09-06 added some page templates
    [BOM-v1.2.csv, Board-v1.3.brd, PiHatOshpark.brd]
2023-10-31 added stepper motor mounts v2 stl and gcode files
    [Stepper+Motor+Mount+1.stl, Stepper+Motor+Mount+2.stl]
2023-11-03 counterweight and cable clip gcode
2023-11-13 failed exe, fixed some warnings and errors, mainly syntax
    [selector_v1.c]
2023-11-13 get position method not working
    [selector_v1.c]
2023-11-13 movd fixed var to be global
    [selector_v1.c]
2023-11-13 pressing key shows highlight, need to fix movement
    [drawing.c, selector_v1.c]
2023-11-13 snapping boxes work but need to fix how they snap to move in intervals
    [selector_v1.c]
2023-11-13 added snapping function to be in shorter intervals
    [selector_v1.c]
2023-11-13 added boundaires so that the box doesn't go outside of the window view
    [selector_v1.c]
2023-11-13 added enter key event to print selector box coordinates temporarily
2023-11-14 added flower image
2023-11-14 change make file executable to use flower image instead
2023-11-14 added flags so that image only shows in the drawing area when entered, need to fix when entered again it disappears
    [selector_v1.c]
2023-11-20 added stl for stepper motor mounts that include attachments to board functionality
    [StepperMotorMount_1_v2.stl, StepperMotorMount_2_v2.stl]
2023-11-20 added gcode for stepper mounts v2
2023-11-25 documentation, gear ratios
2023-11-25 added servo extender and pulley holder stl and gcode
    [StepperMotorMount_1_v2.stl, StepperMotorMount_2_v2.stl, pulley-holder.stl, servo-extender.stl]
2023-11-26 misc bugfixes, point transformation
    [gcode.c, gcode.h, main.h, main.ino, selector_v1.c]
2023-11-27 fixed gcode to L/R
    [gcode.c]
2023-11-29 started working on kinect integration, not working yet
    [main.c, main.h]
2023-11-29 kinect tracking working! now integrate with switch buttons
2023-11-29 lots of progress with kinect + game controller, but problems with moving into selector stage
    [drawable_canvas.c, drawable_canvas.h, gcode.c, main.c, main.h, selector_v1.c]
2023-12-02 last couple of changes here
2023-12-02 moved taggang prototype py code
2023-12-02 serial still not work
    [serialsend.py]
2023-12-02 no more segfaults.... fingers crossed....
2023-12-03 wrong end char in debugging gcode
    [main_nucleo.ino, serialsend.py]
2023-12-03 correct string being sent, but not receieving still in arduino
    [main_nucleo.ino, serialsend.py]
2023-12-03 debug print statements
2023-12-03 WORKING SERIALgit add . added lines of code that allows to read data from arduino
2023-12-04 refactoring, some more work needed to switch between screens though (widgets need to go in a Box)
2023-12-05 persistent drawings in selector stage
2023-12-08 plotter 3d prints
    [gondola-2.stl, gondola-3.stl, stepper-motor-mount-fin-1.stl, stepper-motor-mount-fin-2.stl]
2023-12-08 Revert "merged main from debug-joycond"
    This reverts commit 2d69606d5d68dd96d8c4d2adecdceac5f5c999fa.
    [main.c]
2023-12-08 Revert "It Works"
    This reverts commit 029b50be55894aee2d88405922ab15d503a73d48.
    [main_nucleo.ino, pins.h]
